vsimhas/CPAP_Micronel/assets/debug_video_frames/frame_005.jpg

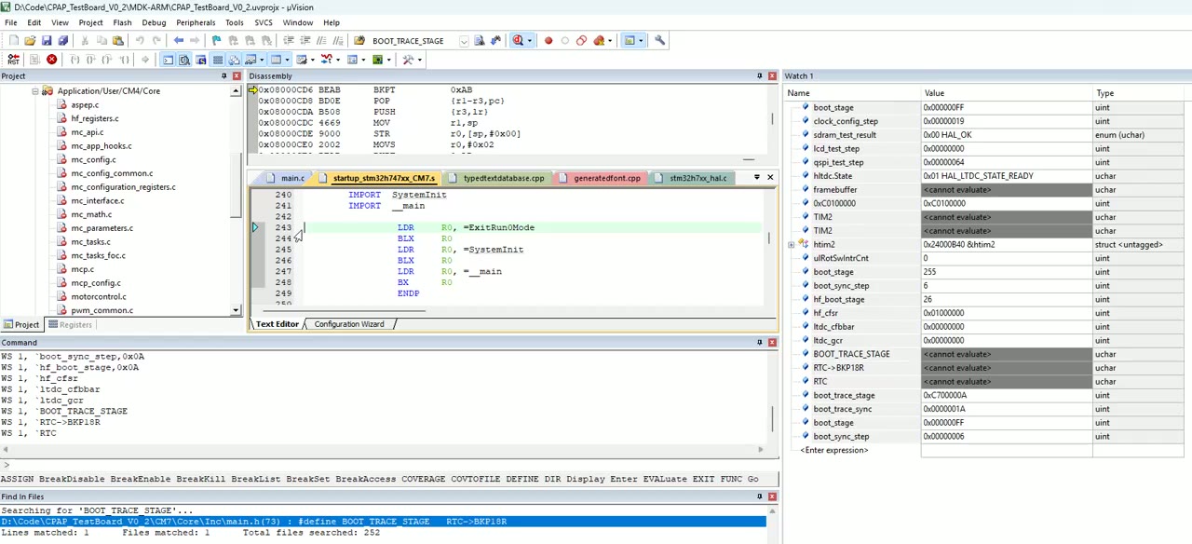
assets/debug_video_frames/frame_005.jpg
