vsimhas/CPAP_Micronel/assets/debug_video_frames/frame_004.jpg

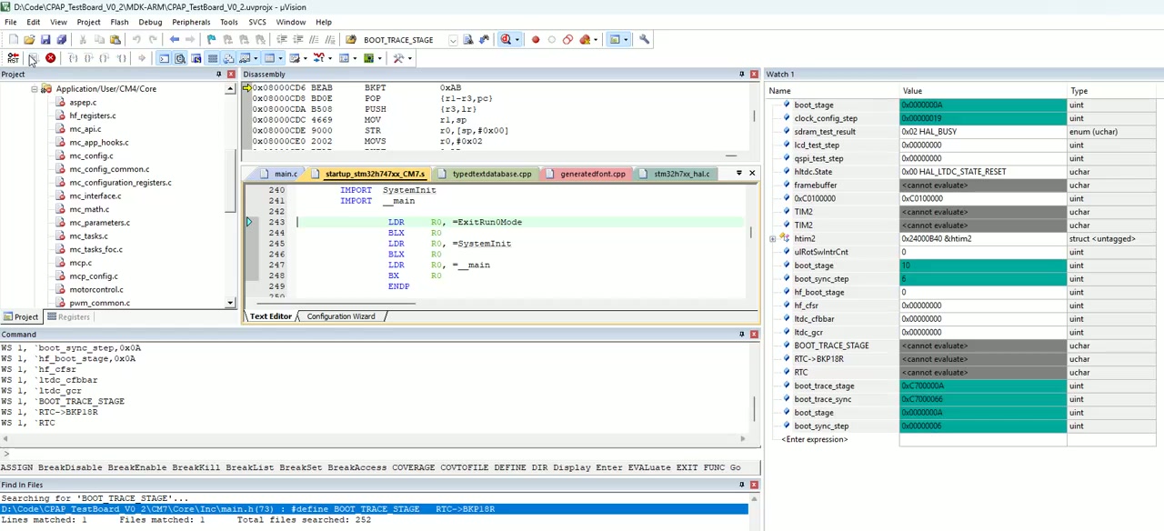
assets/debug_video_frames/frame_004.jpg
