vsimhas/CPAP_Micronel/README.md

# CPAP_InitialCode
Initial code creation and board testing code
