vsimhas/CPAP_Micronel/CM7/TouchGFX/assets/images/__generated/alternate_theme_images_backgrounds_480x272_puzzle.png

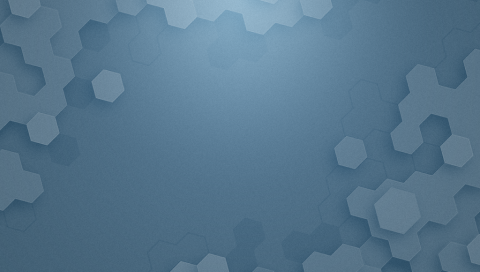
CM7/TouchGFX/assets/images/__generated/alternate_theme_images_backgrounds_480x272_puzzle.png
