vsimhas/CPAP_Micronel/mechanical/WM6850_Quiet_Enclosure/reference/datasheet_outline.png

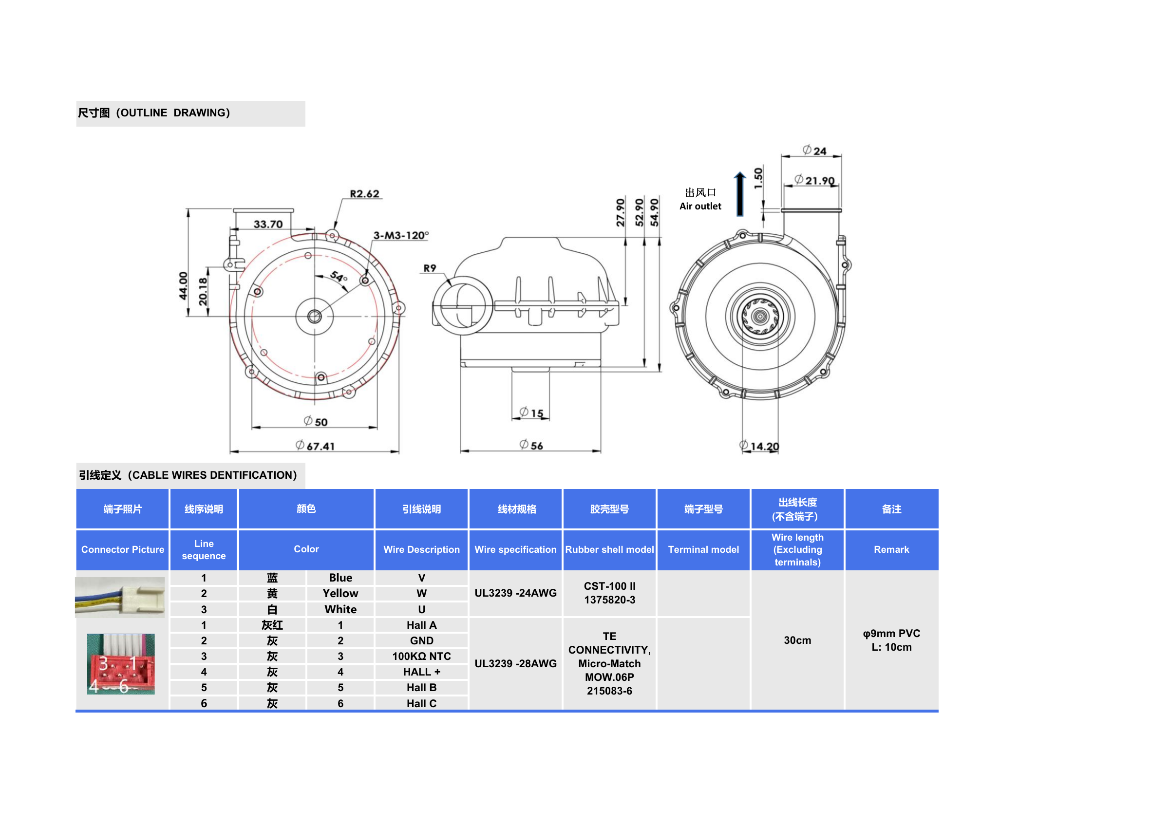
mechanical/WM6850_Quiet_Enclosure/reference/datasheet_outline.png
