vsimhas/CPAP_Micronel/mechanical/WM6850_Quiet_Enclosure/reference/review-6.png

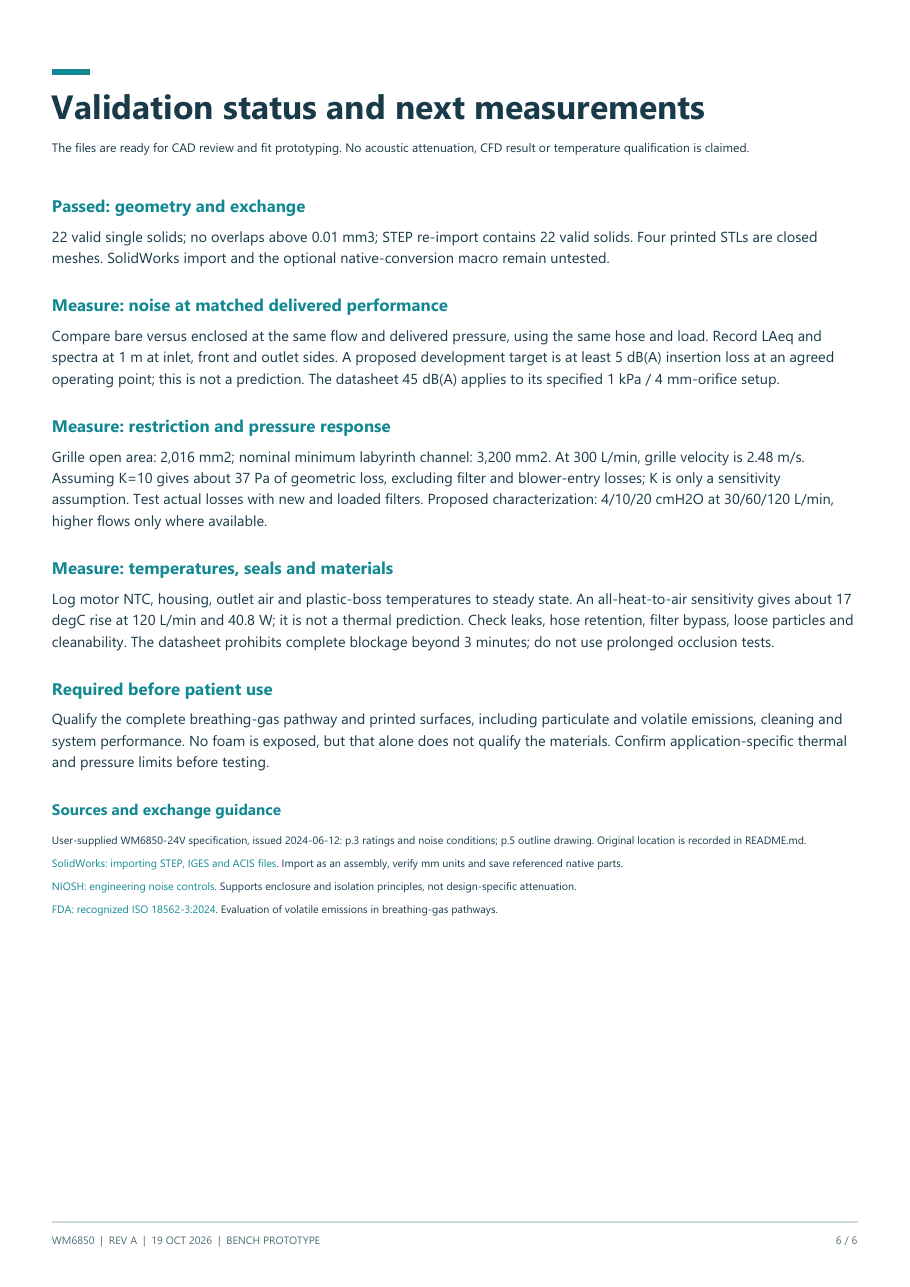
mechanical/WM6850_Quiet_Enclosure/reference/review-6.png
