vsimhas/CPAP_Micronel/mechanical/WM6850_Quiet_Enclosure/cad/step_parts/01_Base_with_intake_labyrinth.step

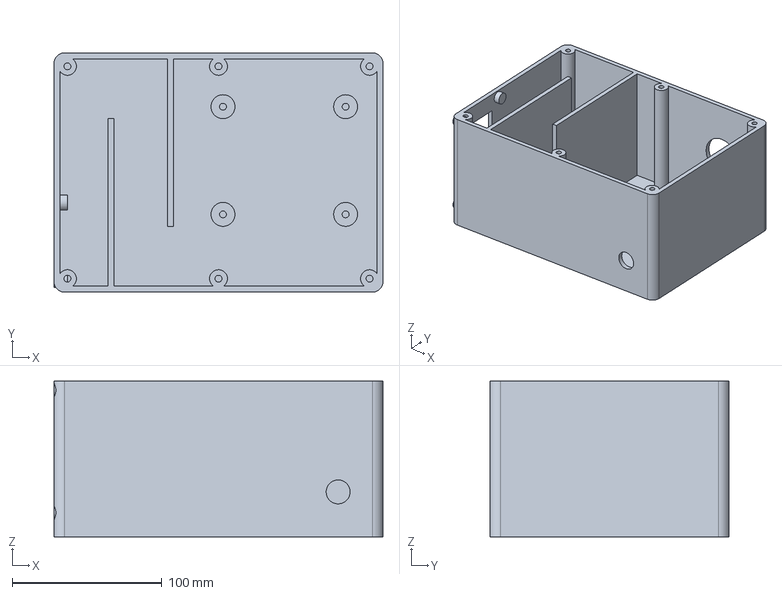
[picture p14: CAD file, 2026-10-20]
mechanical/WM6850_Quiet_Enclosure/cad/step_parts/01_Base_with_intake_labyrinth.step
220.0 x 160.0 x 104.0 mm
