vsimhas/CPAP_Micronel/mechanical/WM6850_Quiet_Enclosure/cad/WM6850_Quiet_Enclosure.step

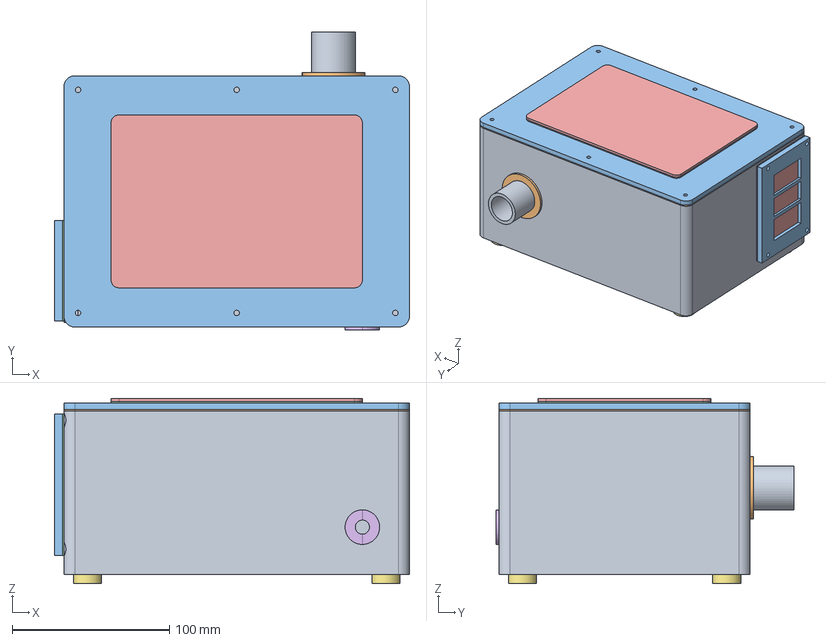
[picture p15: CAD file, 2026-10-20]
mechanical/WM6850_Quiet_Enclosure/cad/WM6850_Quiet_Enclosure.step
226.0 x 190.0 x 118.0 mm
01 Base with intake labyrinth
02 Rim and baffle gasket
03 Removable lid
04 External damping layer
05 External mass plate
06 Isolated blower carrier
07 Isolator 1
07 Isolator 2
07 Isolator 3
07 Isolator 4
08 WM6850 SUPPLIER ENVELOPE ONLY
09 Flexible outlet sleeve
10 Outlet wall grommet
11 Intake filter retainer
12 Filter frame gasket
13 Filter MEDIA ENVELOPE
14 Split cable gland half 1
14 Split cable gland half 2
15 External foot 1
15 External foot 2
15 External foot 3
15 External foot 4
