vsimhas/CPAP_Micronel/mechanical/WM6850_Quiet_Enclosure/cad/step_parts/13_Filter_MEDIA_ENVELOPE.step

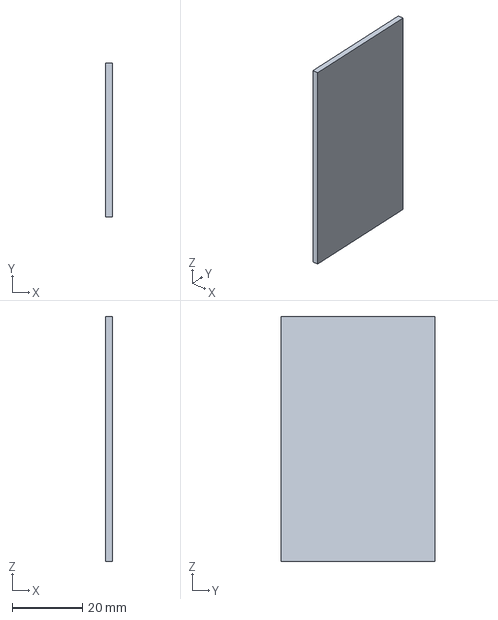
[picture p16: CAD file, 2026-10-20]
mechanical/WM6850_Quiet_Enclosure/cad/step_parts/13_Filter_MEDIA_ENVELOPE.step
2.00 x 44.0 x 70.0 mm
