vsimhas/CPAP_Micronel/mechanical/WM6850_Quiet_Enclosure/cad/step_parts/07_Isolator_3.step

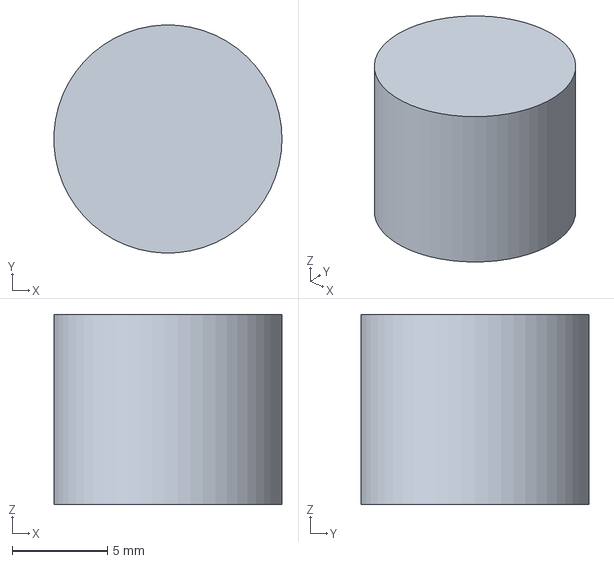
[picture p17: CAD file, 2026-10-20]
mechanical/WM6850_Quiet_Enclosure/cad/step_parts/07_Isolator_3.step
12.0 x 12.0 x 10.0 mm
