vsimhas/CPAP_Micronel/mechanical/WM6850_Quiet_Enclosure/cad/step_parts/05_External_mass_plate.step

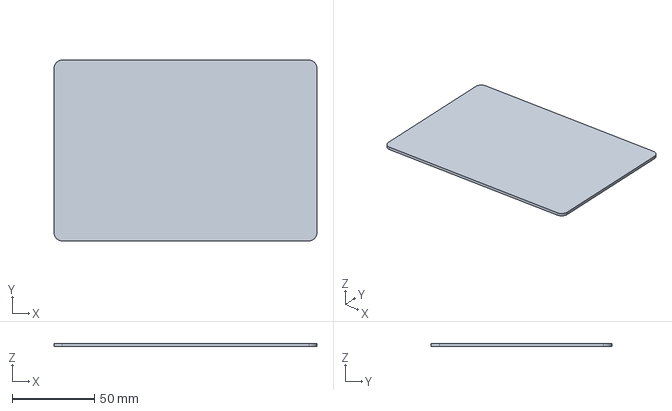
[picture p18: CAD file, 2026-10-20]
mechanical/WM6850_Quiet_Enclosure/cad/step_parts/05_External_mass_plate.step
160.0 x 110.0 x 2.00 mm
