vsimhas/CPAP_Micronel/mechanical/WM6850_Quiet_Enclosure/cad/step_parts/14_Split_cable_gland_half_1.step

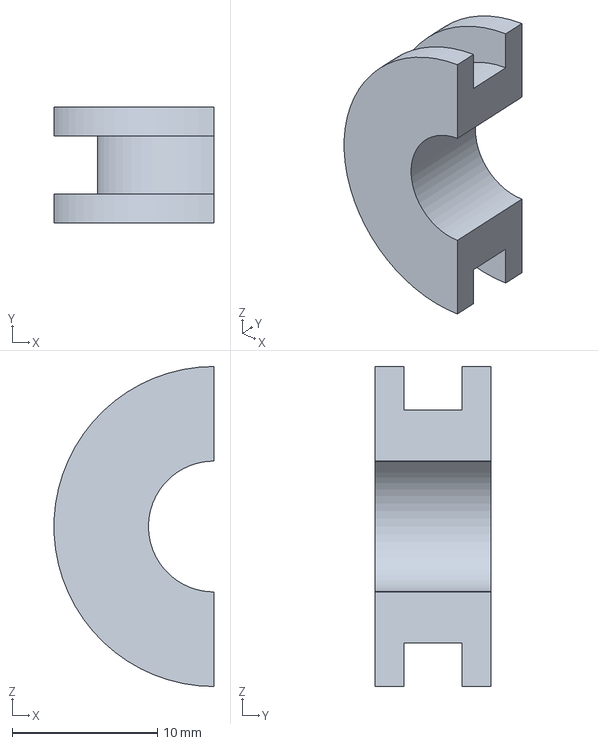
[picture p19: CAD file, 2026-10-20]
mechanical/WM6850_Quiet_Enclosure/cad/step_parts/14_Split_cable_gland_half_1.step
11.0 x 8.00 x 22.0 mm
