vsimhas/CPAP_Micronel/mechanical/WM6850_Quiet_Enclosure/cad/step_parts/15_External_foot_4.step

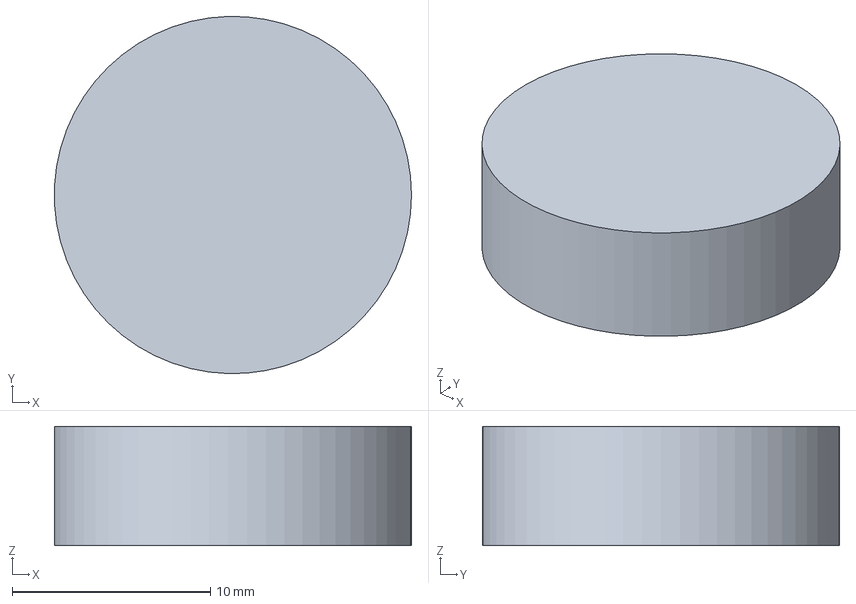
[picture p20: CAD file, 2026-10-20]
mechanical/WM6850_Quiet_Enclosure/cad/step_parts/15_External_foot_4.step
18.0 x 18.0 x 6.00 mm
