vsimhas/CPAP_Micronel/mechanical/WM6850_Quiet_Enclosure/cad/step_parts/08_WM6850_SUPPLIER_ENVELOPE_ONLY.step

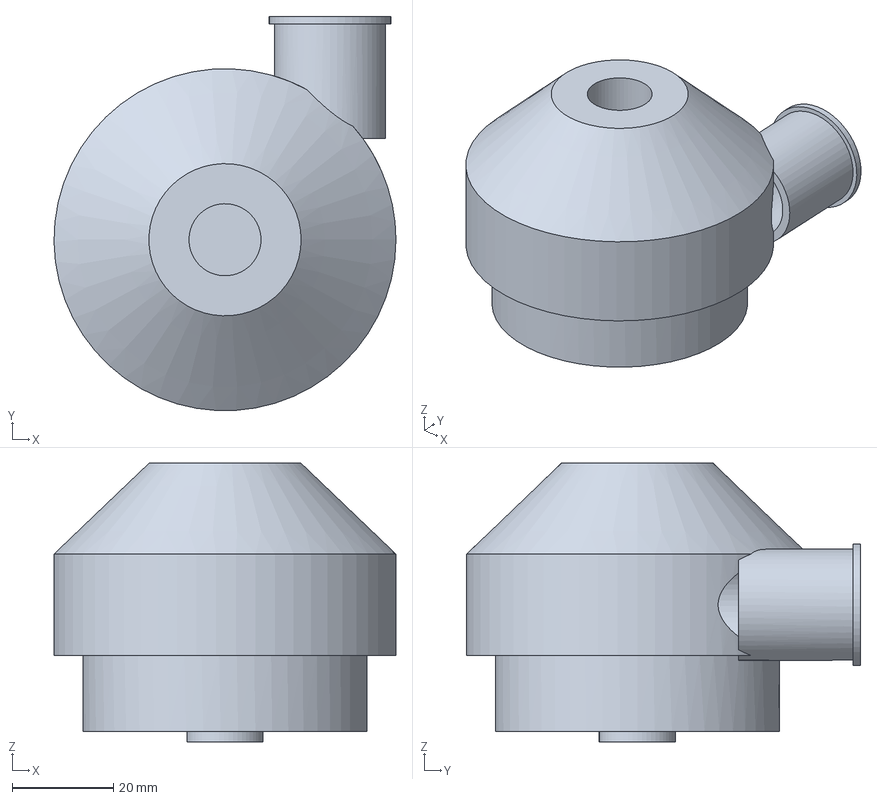
[picture p21: CAD file, 2026-10-20]
mechanical/WM6850_Quiet_Enclosure/cad/step_parts/08_WM6850_SUPPLIER_ENVELOPE_ONLY.step
67.4 x 77.7 x 54.9 mm
