vsimhas/CPAP_Micronel/mechanical/WM6850_Quiet_Enclosure/cad/step_parts/02_Rim_and_baffle_gasket.step

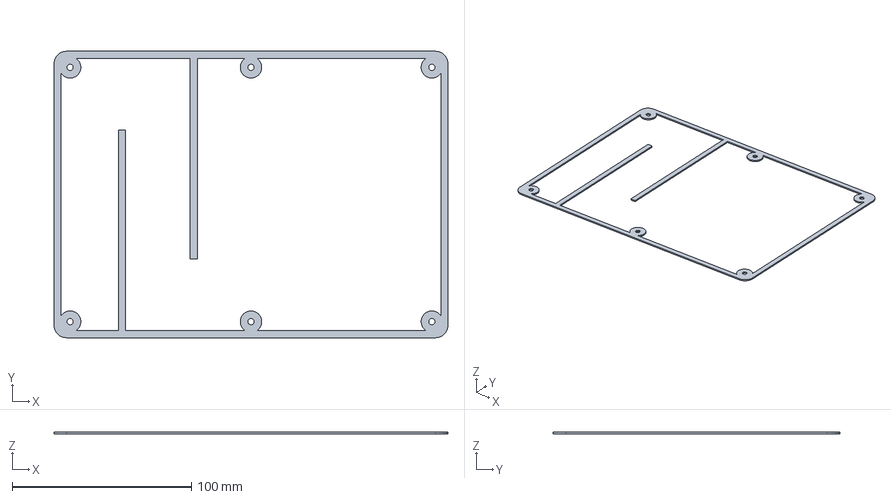
[picture p22: CAD file, 2026-10-20]
mechanical/WM6850_Quiet_Enclosure/cad/step_parts/02_Rim_and_baffle_gasket.step
220.0 x 160.0 x 1.00 mm
