vsimhas/CPAP_Micronel/mechanical/WM6850_Quiet_Enclosure/cad/step_parts/06_Isolated_blower_carrier.step

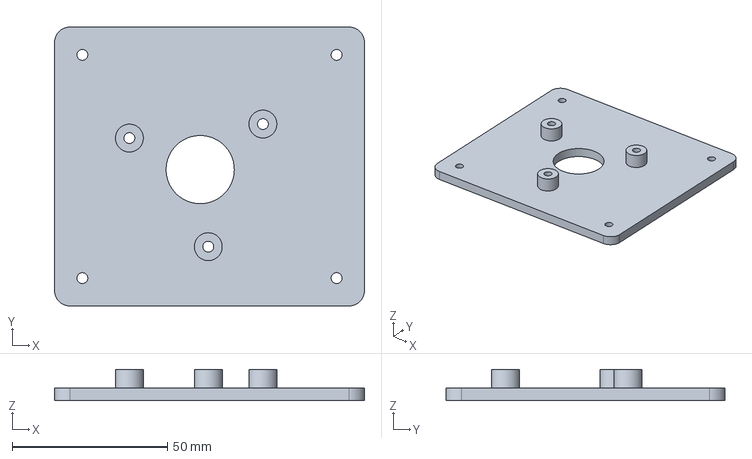
[picture p23: CAD file, 2026-10-20]
mechanical/WM6850_Quiet_Enclosure/cad/step_parts/06_Isolated_blower_carrier.step
100.0 x 90.0 x 10.0 mm
