vsimhas/CPAP_Micronel/mechanical/WM6850_Quiet_Enclosure/cad/step_parts/11_Intake_filter_retainer.step

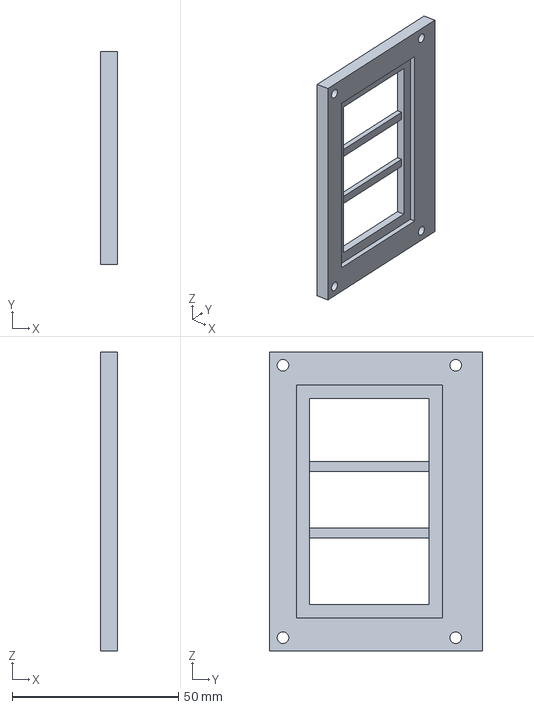
[picture p24: CAD file, 2026-10-20]
mechanical/WM6850_Quiet_Enclosure/cad/step_parts/11_Intake_filter_retainer.step
5.00 x 64.0 x 90.0 mm
