vsimhas/CPAP_Micronel/mechanical/WM6850_Quiet_Enclosure/cad/step_parts/04_External_damping_layer.step

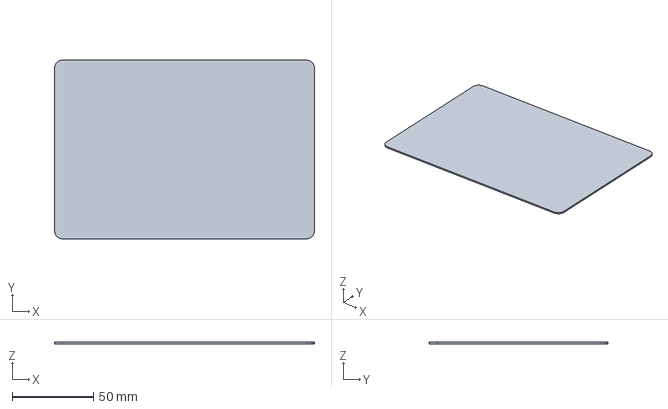
[picture p25: CAD file, 2026-10-20]
mechanical/WM6850_Quiet_Enclosure/cad/step_parts/04_External_damping_layer.step
160.0 x 110.0 x 1.00 mm
