vsimhas/CPAP_Micronel/mechanical/WM6850_Quiet_Enclosure/cad/step_parts/12_Filter_frame_gasket.step

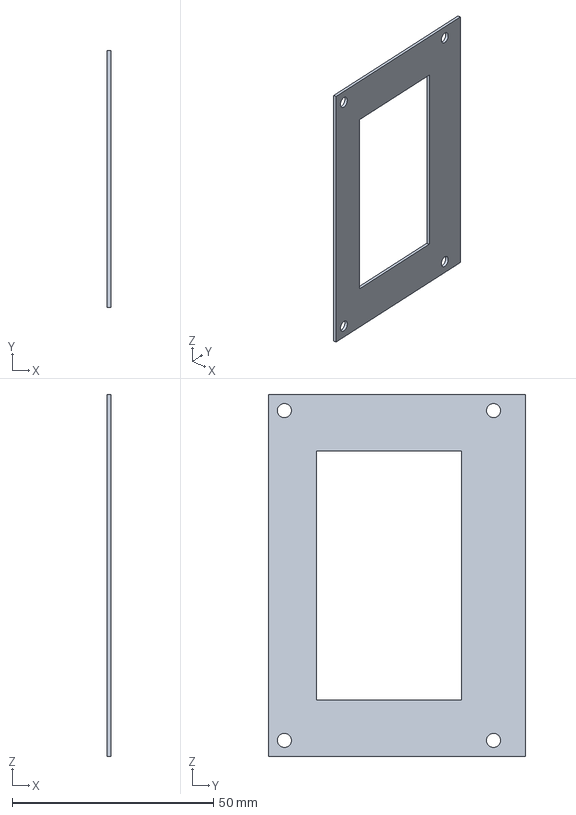
[picture p26: CAD file, 2026-10-20]
mechanical/WM6850_Quiet_Enclosure/cad/step_parts/12_Filter_frame_gasket.step
1.00 x 64.0 x 90.0 mm
