vsimhas/CPAP_Micronel/mechanical/WM6850_Quiet_Enclosure/cad/step_parts/10_Outlet_wall_grommet.step

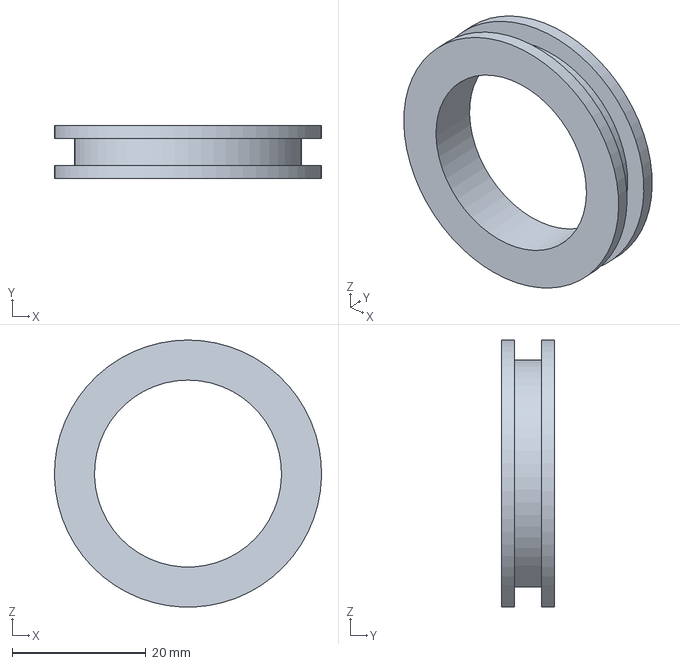
[picture p27: CAD file, 2026-10-20]
mechanical/WM6850_Quiet_Enclosure/cad/step_parts/10_Outlet_wall_grommet.step
40.0 x 8.00 x 40.0 mm
