vsimhas/CPAP_Micronel/mechanical/WM6850_Quiet_Enclosure/cad/step_parts/09_Flexible_outlet_sleeve.step

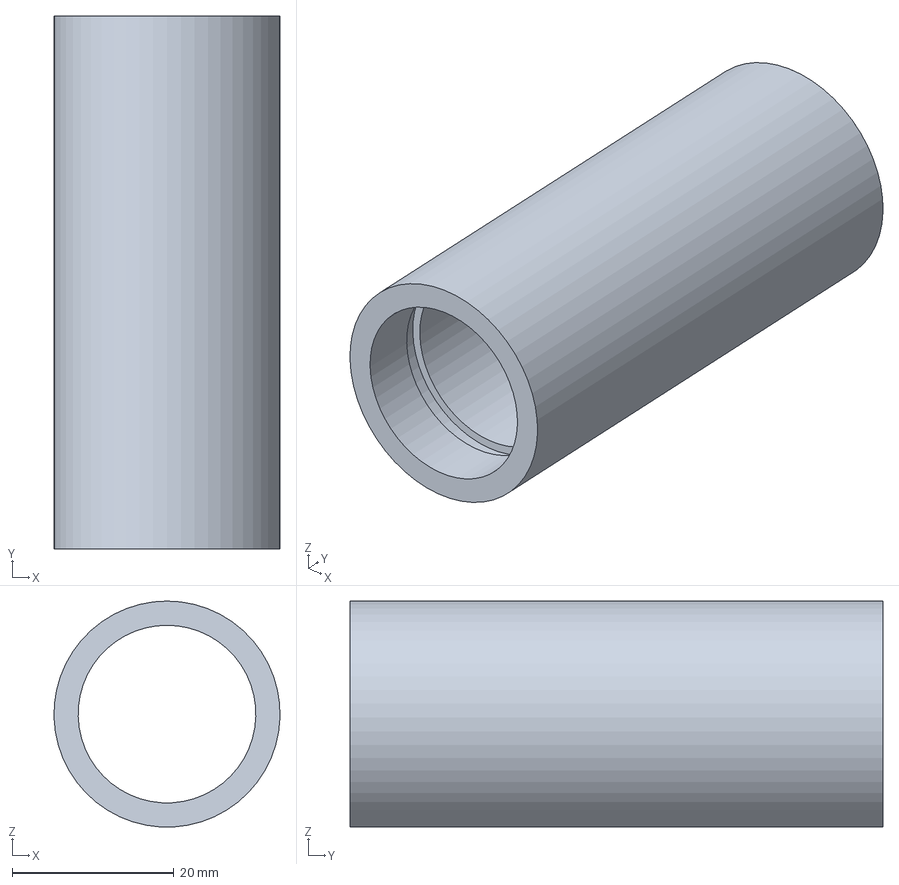
[picture p28: CAD file, 2026-10-20]
mechanical/WM6850_Quiet_Enclosure/cad/step_parts/09_Flexible_outlet_sleeve.step
28.0 x 66.0 x 28.0 mm
