vsimhas/CPAP_Micronel/mechanical/WM6850_Quiet_Enclosure/cad/step_parts/03_Removable_lid.step

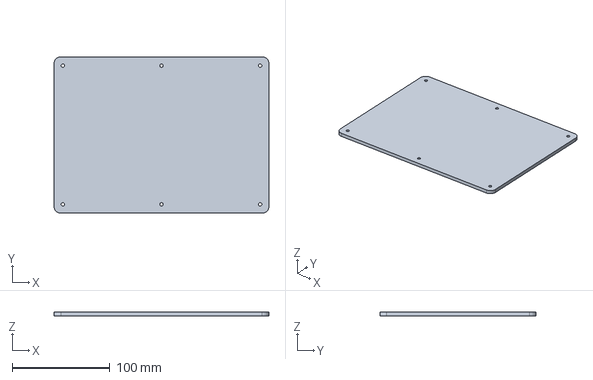
[picture p29: CAD file, 2026-10-20]
mechanical/WM6850_Quiet_Enclosure/cad/step_parts/03_Removable_lid.step
220.0 x 160.0 x 4.00 mm
