vsimhas/CPAP_Micronel/(list of files, cad)

Other CAD files:
mechanical/WM6850_Quiet_Enclosure/cad/step_parts/07_Isolator_2.step
mechanical/WM6850_Quiet_Enclosure/cad/step_parts/07_Isolator_4.step
mechanical/WM6850_Quiet_Enclosure/cad/step_parts/07_Isolator_1.step
mechanical/WM6850_Quiet_Enclosure/cad/step_parts/15_External_foot_2.step
mechanical/WM6850_Quiet_Enclosure/cad/step_parts/15_External_foot_1.step
mechanical/WM6850_Quiet_Enclosure/cad/step_parts/14_Split_cable_gland_half_2.step
mechanical/WM6850_Quiet_Enclosure/cad/step_parts/15_External_foot_3.step
mechanical/WM6850_Quiet_Enclosure/cad/WM6850_Quiet_Enclosure.FCStd
mechanical/WM6850_Quiet_Enclosure/cad/stl_print/01_Base_with_intake_labyrinth.stl
mechanical/WM6850_Quiet_Enclosure/cad/stl_print/03_Removable_lid.stl
mechanical/WM6850_Quiet_Enclosure/cad/stl_print/06_Isolated_blower_carrier.stl
mechanical/WM6850_Quiet_Enclosure/cad/stl_print/11_Intake_filter_retainer.stl
