vsimhas/CPAP_Micronel/mechanical/WM6850_Quiet_Enclosure/output/assembled.png

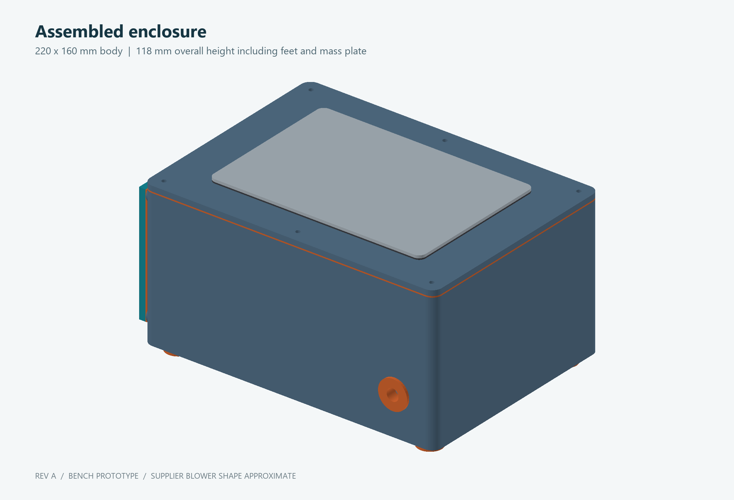
mechanical/WM6850_Quiet_Enclosure/output/assembled.png
