vsimhas/CPAP_Micronel/CM4/Core/Inc/drive_parameters.h

#define DRIVE_PARAMETERS_H
#define FOC_OVERMODULATION_ENABLE           1
#define MAX_APPLICATION_SPEED_RPM           40626
#define MIN_APPLICATION_SPEED_RPM           0
#define M1_SS_MEAS_ERRORS_BEFORE_FAULTS     3
#define VARIANCE_THRESHOLD                  0.25
#define F1                                  8192
#define F2                                  16384
#define F1_LOG                              LOG2((8192))
#define F2_LOG                              LOG2((16384))
#define GAIN1                               -10231
#define GAIN2                               9219
#define PLL_KP_GAIN                         1081
#define PLL_KI_GAIN                         38
#define PLL_KPDIV                           16384
#define PLL_KPDIV_LOG                       LOG2((PLL_KPDIV))
#define PLL_KIDIV                           65535
#define PLL_KIDIV_LOG                       LOG2((PLL_KIDIV))
#define STO_FIFO_DEPTH_DPP                  64
#define STO_FIFO_DEPTH_DPP_LOG              LOG2((64))
#define STO_FIFO_DEPTH_UNIT                 64
#define M1_BEMF_CONSISTENCY_TOL             64
#define M1_BEMF_CONSISTENCY_GAIN            64
#define PARK_ANGLE_COMPENSATION_FACTOR      0
#define REV_PARK_ANGLE_COMPENSATION_FACTOR  0
#define PWM_FREQUENCY                       40000
#define PWM_FREQ_SCALING                    1
#define LOW_SIDE_SIGNALS_ENABLING           ES_GPIO
#define REGULATION_EXECUTION_RATE           2
#define ISR_FREQUENCY_HZ                    (PWM_FREQUENCY/REGULATION_EXECUTION_RATE)
#define PID_TORQUE_KP_DEFAULT               3412
#define PID_TORQUE_KI_DEFAULT               2285
#define PID_TORQUE_KD_DEFAULT               100
#define PID_FLUX_KP_DEFAULT                 3412
#define PID_FLUX_KI_DEFAULT                 2285
#define PID_FLUX_KD_DEFAULT                 100
#define TF_KPDIV                            8192
#define TF_KIDIV                            16384
#define TF_KDDIV                            8192
#define TF_KPDIV_LOG                        LOG2((8192))
#define TF_KIDIV_LOG                        LOG2((16384))
#define TF_KDDIV_LOG                        LOG2((8192))
#define TFDIFFERENTIAL_TERM_ENABLING        DISABLE
#define PID_SPEED_KP_DEFAULT                1637/(SPEED_UNIT/10)
#define PID_SPEED_KI_DEFAULT                1024/(SPEED_UNIT/10)
#define PID_SPEED_KD_DEFAULT                0/(SPEED_UNIT/10)
#define SPEED_LOOP_FREQUENCY_HZ             (uint16_t)1000
#define SP_KPDIV                            128
#define SP_KIDIV                            16384
#define SP_KDDIV                            16
#define SP_KPDIV_LOG                        LOG2((128))
#define SP_KIDIV_LOG                        LOG2((16384))
#define SP_KDDIV_LOG                        LOG2((16))
#define PID_SPEED_INTEGRAL_INIT_DIV         0
#define SPD_DIFFERENTIAL_TERM_ENABLING      DISABLE
#define IQMAX_A                             1.316
#define DEFAULT_CONTROL_MODE                MCM_SPEED_MODE
#define DEFAULT_TARGET_SPEED_RPM            14625
#define DEFAULT_TARGET_SPEED_UNIT           (DEFAULT_TARGET_SPEED_RPM*SPEED_UNIT/U_RPM)
#define DEFAULT_TORQUE_COMPONENT_A          0
#define DEFAULT_FLUX_COMPONENT_A            0
#define OV_VOLTAGE_THRESHOLD_V              28.0
#define UD_VOLTAGE_THRESHOLD_V              7.0
#ifdef NOT_IMPLEMENTED
#define ON_OVER_VOLTAGE                     TURN_OFF_PWM
#endif
#define OV_TEMPERATURE_THRESHOLD_C          110
#define OV_TEMPERATURE_HYSTERESIS_C         10
#define HW_OV_CURRENT_PROT_BYPASS           DISABLE
#define OVP_INVERTINGINPUT_MODE             INT_MODE
#define OVP_INVERTINGINPUT_MODE2            INT_MODE
#define OVP_SELECTION                       COMP_Selection_COMP1
#define OVP_SELECTION2                      COMP_Selection_COMP1
#define PHASE1_DURATION                     1000
#define PHASE1_FINAL_SPEED_UNIT             (0*SPEED_UNIT/U_RPM)
#define PHASE1_FINAL_CURRENT_A              1.316
#define PHASE2_DURATION                     4322
#define PHASE2_FINAL_SPEED_UNIT             (16250*SPEED_UNIT/U_RPM)
#define PHASE2_FINAL_CURRENT_A              1.316
#define PHASE3_DURATION                     0
#define PHASE3_FINAL_SPEED_UNIT             (16250*SPEED_UNIT/U_RPM)
#define PHASE3_FINAL_CURRENT_A              1.316
#define PHASE4_DURATION                     0
#define PHASE4_FINAL_SPEED_UNIT             (16250*SPEED_UNIT/U_RPM)
#define PHASE4_FINAL_CURRENT_A              1.316
#define PHASE5_DURATION                     0
#define PHASE5_FINAL_SPEED_UNIT             (16250*SPEED_UNIT/U_RPM)
#define PHASE5_FINAL_CURRENT_A              1.316
#define ENABLE_SL_ALGO_FROM_PHASE           2
#define STARTING_ANGLE_DEG                  0
#define OBS_MINIMUM_SPEED_RPM               14625
#define NB_CONSECUTIVE_TESTS                2
#define SPEED_BAND_UPPER_LIMIT              17
#define SPEED_BAND_LOWER_LIMIT              15
#define TRANSITION_DURATION                 25
#define  M1_VBUS_SAMPLING_TIME              LL_ADC_SAMPLING_CYCLE(64)
#define  M1_TEMP_SAMPLING_TIME              LL_ADC_SAMPLING_CYCLE(64)
#define ADC_SAMPLING_CYCLES                 (8 + SAMPLING_CYCLE_CORRECTION)
