vsimhas/CPAP_Micronel/CM4/Core/Inc/main.h

#define M1_BUS_VOLTAGE_Pin GPIO_PIN_0
#define M1_BUS_VOLTAGE_GPIO_Port GPIOA
#define M1_CURR_AMPL_U_Pin GPIO_PIN_1
#define M1_CURR_AMPL_U_GPIO_Port GPIOA
#define M1_DP_Pin GPIO_PIN_6
#define M1_DP_GPIO_Port GPIOA
#define M1_CURR_AMPL_W_Pin GPIO_PIN_7
#define M1_CURR_AMPL_W_GPIO_Port GPIOA
#define M1_TEMPERATURE_Pin GPIO_PIN_4
#define M1_TEMPERATURE_GPIO_Port GPIOC
#define M1_CURR_AMPL_V_Pin GPIO_PIN_1
#define M1_CURR_AMPL_V_GPIO_Port GPIOB
#define UART_TX_Pin GPIO_PIN_10
#define UART_TX_GPIO_Port GPIOB
#define UART_RX_Pin GPIO_PIN_11
#define UART_RX_GPIO_Port GPIOB
#define STSPIN_STBY_Pin GPIO_PIN_13
#define STSPIN_STBY_GPIO_Port GPIOB
#define M1_PWM_EN_V_Pin GPIO_PIN_14
#define M1_PWM_EN_V_GPIO_Port GPIOB
#define M1_PWM_EN_W_Pin GPIO_PIN_15
#define M1_PWM_EN_W_GPIO_Port GPIOB
#define MOT_POW_EN_Pin GPIO_PIN_11
#define MOT_POW_EN_GPIO_Port GPIOD
#define M1_PWM_UH_Pin GPIO_PIN_6
#define M1_PWM_UH_GPIO_Port GPIOC
#define M1_PWM_VH_Pin GPIO_PIN_7
#define M1_PWM_VH_GPIO_Port GPIOC
#define M1_PWM_EN_U_Pin GPIO_PIN_13
#define M1_PWM_EN_U_GPIO_Port GPIOH
#define GREEN_LED_Pin GPIO_PIN_4
#define GREEN_LED_GPIO_Port GPIOD
#define M1_PWM_WH_Pin GPIO_PIN_7
#define M1_PWM_WH_GPIO_Port GPIOI
#define BRAKE_PWM_Pin GPIO_PIN_4
#define BRAKE_PWM_GPIO_Port GPIOB
