vsimhas/CPAP_Micronel/CM7/Core/Inc/main.h

#define BOOT_TRACE_STAGE   boot_trace_stage
#define BOOT_TRACE_SYNC    boot_trace_sync
#define SDIO_DET_Pin GPIO_PIN_3
#define SDIO_DET_GPIO_Port GPIOE
#define SPI4_CS1_Pin GPIO_PIN_4
#define SPI4_CS1_GPIO_Port GPIOE
#define NFC_INT_Pin GPIO_PIN_8
#define NFC_INT_GPIO_Port GPIOI
#define NFC_INT_EXTI_IRQn EXTI9_5_IRQn
#define OTG_FS_PWR_ON_Pin GPIO_PIN_13
#define OTG_FS_PWR_ON_GPIO_Port GPIOC
#define SPI1_CS_Pin GPIO_PIN_4
#define SPI1_CS_GPIO_Port GPIOA
#define BL_CTL_Pin GPIO_PIN_0
#define BL_CTL_GPIO_Port GPIOB
#define SPI2_CS_Pin GPIO_PIN_12
#define SPI2_CS_GPIO_Port GPIOB
#define SPI4_CS2_Pin GPIO_PIN_3
#define SPI4_CS2_GPIO_Port GPIOG
#define ESP32_TX_Pin GPIO_PIN_5
#define ESP32_TX_GPIO_Port GPIOD
#define ESP32_RX_Pin GPIO_PIN_6
#define ESP32_RX_GPIO_Port GPIOD
#define ROT_SW_Pin GPIO_PIN_5
#define ROT_SW_GPIO_Port GPIOB
#define ROT_SW_EXTI_IRQn EXTI9_5_IRQn
