vsimhas/CPAP_Micronel/CM7/Core/Inc/blower_ctrl.h

/**
  ******************************************************************************
  * @file    blower_ctrl.h
  * @brief   Outer pressure-control PID for the CPAP blower. Runs on CM7,
  *          posts speed targets to the CM4 motor controller via the existing
  *          blower IPC mailbox.
  *
  *  Topology
  *  --------
  *      Setpoint (cmH2O)
  *           |
  *           v   (slewed)
  *      [PID @ 200 Hz on CM7]  <--- pressure_meas (cmH2O, from measPS)
  *           |
  *           v   (rpm reference)
  *      [BlowerIpc_CM7_SetSpeedRpmSilent]  ->  CM4 FOC inner loop
  *
  *  Why gain scheduling
  *  -------------------
  *  CPAP blowers are non-linear: at low therapy pressures (~4 cmH2O) the
  *  RPM-to-pressure slope is steep (small RPM step -> large pressure swing,
  *  so the loop needs LOW gains), while at high pressures (~20 cmH2O) the
  *  blower has already done most of the air-moving work and small pressure
  *  changes need bigger RPM corrections (so the loop needs HIGHER gains).
  *
  *  This module exposes three (Kp, Ki, Kd) sets selected by the *current
  *  setpoint*. We schedule on the setpoint - not the measurement - because
  *  setpoint is monotonic and slew-limited, while a noisy measurement at
  *  the boundary would chatter between zones.
  *
 *  All gains and feature flags are debugger-visible volatile globals so
 *  you can tune live with the Keil watch window or via STM Studio.
 *
 *  WM6850 reference mode
 *  ---------------------
 *  Set g_blower_ctrl_wm6850_mode = 1 for pressure_pid.c-compatible behaviour
 *  (see blower_ctrl.c design note 8). PID runs at 100 Hz (every 2nd 5 ms
 *  SensorTask tick). Overrides FF/slew/zones/tube-comp on the PID path.
 *  Tune via g_blower_ctrl_wm6850_kp/ki/kd.
  ******************************************************************************
  */

#ifndef BLOWER_CTRL_H
#define BLOWER_CTRL_H

#ifdef __cplusplus
extern "C" {
#endif

#include <stdint.h>
#include <stdbool.h>

/* CPAP therapy range expected by the controller. The setpoint is clamped
 * to [BLOWER_CTRL_SETPOINT_MIN, BLOWER_CTRL_SETPOINT_MAX] regardless of
 * what the caller passes in. */
#define BLOWER_CTRL_SETPOINT_MIN_CMH2O   4.0f
#define BLOWER_CTRL_SETPOINT_MAX_CMH2O   25.0f

/* Upper bound on the fan-curve coefficient (physicsFfRpmForSetpointAndFlow).
 *
 * Lives in the header because the USB setter has to clamp to the SAME value.
 * It did not, and that cost two weeks: when this ceiling was raised from
 * 0.001 on 2026-09-08 the setter in telemetry_stream.c kept its own 0.001
 * literal, so every "blower set physics_ff_c_fan" above 0.001 was silently
 * clipped - while still acking. Bench sweeps of c_fan therefore measured a
 * constant, and three of them read as "c_fan has no effect" before the
 * extended D line showed the fan term pinned at 0.001 x Q^2.
 * Keep the two in step by keeping them one symbol. */
#define BLOWER_CTRL_C_FAN_MAX            0.005f

/* Zone boundaries used for gain scheduling. Anything below LOW_HI uses the
 * "low" set; anything between LOW_HI and MID_HI uses "mid"; anything above
 * MID_HI uses "high". A small hysteresis prevents zone flapping at the
 * boundaries. */
#define BLOWER_CTRL_ZONE_LOW_HI_CMH2O    8.0f
#define BLOWER_CTRL_ZONE_MID_HI_CMH2O    15.0f
#define BLOWER_CTRL_ZONE_HYST_CMH2O      0.5f

/* Identifies which gain set was used in the most recent step. Useful to
 * watch in the debugger; also drives the Diagnostics page if you want to
 * surface it later. */
typedef enum
{
    BLOWER_CTRL_ZONE_LOW = 0,
    BLOWER_CTRL_ZONE_MID,
    BLOWER_CTRL_ZONE_HIGH
} BlowerCtrlZone_t;

/* Public API ---------------------------------------------------------------- */

/* Reset internal state and load default gains. Call once before the loop
 * task starts using the controller. */
void BlowerCtrl_Init(void);

/* Master enable/disable. While disabled the controller does not post any
 * IPC commands - manual blower control (g_bench_blower_enable, debugger writes)
 * keeps working. While enabled the controller owns target_speed_rpm. */
void BlowerCtrl_SetEnable(bool en);
bool BlowerCtrl_IsEnabled(void);

/* Update the user setpoint in cmH2O. The controller slews internally
 * toward this target at g_blower_ctrl_slew_cmh2o_per_s so a step input
 * does not provoke huge transient overshoot or anti-windup glitches. */
void BlowerCtrl_SetSetpoint(float cmh2o);
/* Set user + slewed setpoint immediately (therapy start / EPR snap). */
void BlowerCtrl_SnapSetpoint(float cmh2o);
/* Set therapy target without forcing slewed SP (mask-resume soft climb). */
void BlowerCtrl_SetUserSetpointOnly(float cmh2o);
float BlowerCtrl_GetSetpoint(void);          /* user setpoint              */
float BlowerCtrl_GetSetpointSlewed(void);    /* internal slewed target     */
float BlowerCtrl_GetMeasured(void);          /* PID measurement (mask est.) */
float BlowerCtrl_GetSensorCmh2o(void);       /* device-side AMS5935 cmH2O  */
float BlowerCtrl_GetOutputRpm(void);         /* last commanded rpm         */
/* Last PID step requested the upper cap, or posted within 50 RPM of it.
 * Uses the active cap (including WM6850), not the lower-limit saturation flag.
 * False with the PID disabled; therapy observes the preceding PID tick. */
bool BlowerCtrl_IsUpperLimited(void);

/* Open-loop manual blower (USB / bench). Stops pressure PID and posts RPM
 * targets directly to CM4 with optional CM4-side ramp. */
void BlowerCtrl_ManualStart(int32_t rpm, uint16_t ramp_ms);
void BlowerCtrl_ManualSetSpeed(int32_t rpm, uint16_t ramp_ms);
void BlowerCtrl_ManualStop(void);
/* Clear manual mode without posting STOP (mask-on resume). */
void BlowerCtrl_ClearManualFlag(void);
bool BlowerCtrl_IsManualActive(void);

/* Run one PID iteration. Should be called periodically from the sensor
 * task at 5 ms (200 Hz). WM6850 mode decimates internally to 100 Hz.
 * dt_s is the elapsed seconds since the previous call. */
void BlowerCtrl_Step(float dt_s);

/* Enforce mutual exclusion between physics FF and legacy sqrt/flow/dip FF. */
void BlowerCtrl_EnforceFfMutualExclusion(void);

/* CPAP Plateau preset (AirSense-like flat pressure platform).
 * Prefer=1 → sticky A/B flag; Sync applies on CPAP / restores on Autoset.
 * Preset: sqrt FF only, no flow/physics/dip FF, soft P gains, heavier LPF. */
void BlowerCtrl_SetCpapPlateauPrefer(bool prefer);
bool BlowerCtrl_IsCpapPlateauPreferred(void);
bool BlowerCtrl_IsCpapPlateauActive(void);

/* CPAP Hybrid: Physics FF on inspiration, plateau-style hold on expiration.
 * Mutually exclusive with Plateau prefer. Disable via prefer=0 if not helpful. */
void BlowerCtrl_SetCpapHybridPrefer(bool prefer);
bool BlowerCtrl_IsCpapHybridPreferred(void);
bool BlowerCtrl_IsCpapHybridActive(void);

/* Apply/restore Plateau + Hybrid for current therapy mode (CPAP vs Autoset). */
void BlowerCtrl_SyncCpapProfilesForMode(uint8_t therapy_mode);

/* Deprecated alias — calls SyncCpapProfilesForMode. */
void BlowerCtrl_SyncCpapPlateauForMode(uint8_t therapy_mode);

/* After mask-off hold: snap setpoint and reseed FF/PID so pressure
 * recovers to therapy target instead of lingering near hold-RPM pressure.
 * Call AFTER BlowerCtrl_SetEnable(true) so rising-edge init cannot wipe the seed. */
void BlowerCtrl_ReseedForTherapyResume(float target_cmh2o);

/* Mask reconnect: set therapy target but start slew/RPM from the hold point
 * so sqrt-FF does not jump straight to full steady-state (pressure overshoot). */
void BlowerCtrl_BeginMaskResume(float target_cmh2o, float start_rpm);

/* After mask reconnect, ignore Vivo Q_patient in flow/dip FF for ms (MeanRatio
 * reseed briefly attributes fill flow to the patient). */
void BlowerCtrl_SuppressPatientFlowFf(uint32_t duration_ms);

/* Floor commanded RPM for duration_ms after mask-on (prevents Step posting 0). */
void BlowerCtrl_SetResumeRpmFloor(float rpm, uint32_t duration_ms);

/* Sqrt-FF estimate of open-circuit RPM for a pressure target (debug/resume). */
float BlowerCtrl_EstimateSteadyStateRpm(float target_cmh2o);

/* Therapy parks the blower itself during mask-off, with the PID disabled and
 * Step() no longer refreshing the output registers. Publish the parked RPM so
 * GetOutputRpm() reports what the motor is actually being asked for instead of
 * the last pre-park command (the safety supervisor and telemetry read it). */
void BlowerCtrl_NoteParkedRpm(float rpm);

#ifdef __cplusplus
}
#endif

#endif /* BLOWER_CTRL_H */
