vsimhas/CPAP_Micronel/CM7/Core/Inc/pressure_sensors.h

#ifndef __PRESSURE_SENSORS_H
#define __PRESSURE_SENSORS_H

#include "stm32h7xx_hal.h"
#include <stdint.h>

typedef struct
{
    uint8_t status;
    uint32_t pressure_raw;
    uint32_t temperature_raw;
    float pressure;
    float temperature_c;
} AMS5935_Data_t;

typedef struct
{
    SPI_HandleTypeDef *hspi;

    GPIO_TypeDef *cs_port;
    uint16_t cs_pin;

    GPIO_TypeDef *eoc_port;
    uint16_t eoc_pin;
    uint8_t use_eoc;

    float p_min;
    float p_max;

    /* Last conversion that was not busy / memory-error / overflow.
     * ReadRaw substitutes this when the sensor reports a bad sample so
     * Flow_Update / PID never see a one-tick garbage ΔP. */
    uint8_t last_valid;
    AMS5935_Data_t last_good;

    /* 1 = the sample just returned by ReadRaw is a repeat of last_good,
     * not a finished conversion. Callers must not treat it as new data:
     * a frozen ΔP looks perfectly "quiet" to the auto-zero detector and
     * steps when fresh data resumes. */
    uint8_t held_last;
    uint32_t held_count;

    /* Opt-in, set by the caller BEFORE AMS5935_Init (Init leaves it alone).
     * 1 = a genuine over-range reading (analog-overflow status, or a payload
     * outside the 10-90% digital span) is returned as FULL SCALE - p_max or
     * p_min - instead of repeating the last good sample.
     *
     * Why: holding the last good sample is right for a torn or busy read,
     * which is a glitch, but wrong for over-range, which is information. On
     * the ±5 mbar flow sensor, over-range means total flow is ABOVE ~93 slm.
     * Holding instead froze the published flow at whatever it had reached on
     * the way up - measured 26.2, 40.7 and 52.6 slm on three runs - so a
     * disconnect-sized flow read as ordinary breathing, low enough to sit
     * under the mask-off enter threshold. Full scale is a true lower bound.
     *
     * Busy and memory-error reads still hold, saturation or not. */
    uint8_t saturate_on_overflow;

    /* 1 = the sample just returned by ReadRaw is a clipped full-scale value.
     * It IS fresh data (held_last is 0) - the quantity really is at least
     * this large - but consumers that need the true magnitude should know. */
    uint8_t saturated_last;
    uint32_t saturated_count;
} AMS5935_HandleTypeDef;

HAL_StatusTypeDef AMS5935_Init(AMS5935_HandleTypeDef *dev);
HAL_StatusTypeDef AMS5935_StartSingleMeasurement(AMS5935_HandleTypeDef *dev);
HAL_StatusTypeDef AMS5935_StartOversamplingMeasurement(AMS5935_HandleTypeDef *dev);
HAL_StatusTypeDef AMS5935_ReadRaw(AMS5935_HandleTypeDef *dev, AMS5935_Data_t *data);
HAL_StatusTypeDef AMS5935_ReadMeasurement(AMS5935_HandleTypeDef *dev,
                                          AMS5935_Data_t *data,
                                          uint8_t oversampling);

float AMS5935_ConvertPressure(uint32_t raw_p, float p_min, float p_max);
float AMS5935_ConvertTemperature(uint32_t raw_t);

/* 1 = last ReadRaw returned a repeated (held) sample, not fresh data. */
uint8_t AMS5935_WasSampleHeld(const AMS5935_HandleTypeDef *dev);

/* 1 = last ReadRaw returned a clipped full-scale sample (see
 * saturate_on_overflow). Fresh, but a lower bound rather than a value. */
uint8_t AMS5935_WasSampleSaturated(const AMS5935_HandleTypeDef *dev);

uint8_t AMS5935_StatusBusy(uint8_t status);
uint8_t AMS5935_StatusMemoryError(uint8_t status);
uint8_t AMS5935_StatusOverflow(uint8_t status);

extern volatile HAL_StatusTypeDef g_pressure_spi_last_status;
extern volatile uint16_t g_pressure_analog_adc_raw;
extern float g_pressure_analog_mbar;

uint16_t pressure_sensor_read_analog_adc_raw(void);

#endif
