vsimhas/CPAP_Micronel/MCSDK_v6.4.2-Full/MotorControl/MCSDK/MCLib/H7xx/Src/r3_2_h7xx_pwm_curr_fdbk.c

/**
  ******************************************************************************
  * @file    r3_2_h7xx_pwm_curr_fdbk.c
  * @author  Motor Control SDK Team, ST Microelectronics
  * @brief   This file provides firmware functions that implement current sensor
  *          class to be stantiated when the three shunts current sensing
  *          topology is used.
  * 
  *          It is specifically designed for STM32H7XX microcontrollers and
  *          implements the successive sampling of motor current using two ADCs.
  *           + MCU peripheral and handle initialization function
  *           + three shunt current sensing
  *           + space vector modulation function
  *           + ADC sampling function
  *
  ******************************************************************************
  * @attention
  *
  * <h2><center>&copy; Copyright (c) 2026 STMicroelectronics.
  * All rights reserved.</center></h2>
  *
  * This software component is licensed by ST under Ultimate Liberty license
  * SLA0044, the "License"; You may not use this file except in compliance with
  * the License. You may obtain a copy of the License at:
  *                             www.st.com/SLA0044
  *
  ******************************************************************************
  *
  * @ingroup R3_2_H7XX_pwm_curr_fdbk
  */

/* Includes ------------------------------------------------------------------*/
#include "r3_2_h7xx_pwm_curr_fdbk.h"
#include "mc_type.h"

/** @addtogroup MCSDK
  * @{
  */


/** @addtogroup ConvFOC
  * @{
  */

/** @addtogroup MCLLAPI
  * @{
  */
/** @addtogroup pwm_curr_fdbk
  * @{
  */

/** @addtogroup R3_2_pwm_curr_fdbk
  * @{
  */


/* Private defines -----------------------------------------------------------*/
#define TIMxCCER_MASK_CH123        ((uint16_t)  (LL_TIM_CHANNEL_CH1|LL_TIM_CHANNEL_CH1N|\
                                                 LL_TIM_CHANNEL_CH2|LL_TIM_CHANNEL_CH2N|\
                                                 LL_TIM_CHANNEL_CH3|LL_TIM_CHANNEL_CH3N))
#define NB_CONVERSIONS 16u
#define CCMR2_CH4_DISABLE 0x8FFFu   //

/* Private typedef -----------------------------------------------------------*/

/* Private function prototypes -----------------------------------------------*/
static void R3_2_TIMxInit( TIM_TypeDef * TIMx, PWMC_Handle_t * pHdl );
static void R3_2_ADCxInit( ADC_TypeDef * ADCx );
__STATIC_INLINE uint16_t R3_2_WriteTIMRegisters( PWMC_Handle_t * pHdl, uint16_t hCCR4Reg  );
static void R3_2_HFCurrentsPolarizationAB( PWMC_Handle_t * pHdl,ab_t * Iab );
static void R3_2_HFCurrentsPolarizationC( PWMC_Handle_t * pHdl, ab_t * Iab );
static void R3_2_SetAOReferenceVoltage( uint32_t DAC_Channel, uint16_t hDACVref );
uint16_t R3_2_SetADCSampPointPolarization( PWMC_Handle_t * pHdl) ;
static void R3_2_RLGetPhaseCurrents( PWMC_Handle_t * pHdl, ab_t * pStator_Currents );
static void R3_2_RLTurnOnLowSides( PWMC_Handle_t * pHdl, uint32_t ticks );
static void R3_2_RLSwitchOnPWM( PWMC_Handle_t * pHdl );

/*
  * @brief  Initializes TIMx, ADC, GPIO, DMA1 and NVIC for current reading
  *         in three shunt topology using STM32H7XX and two ADCs.
  * 
  * @param  pHandle: Handler of the current instance of the PWM component.
  */
__weak void R3_2_Init( PWMC_R3_2_Handle_t * pHandle )
{
  R3_2_OPAMPParams_t * OPAMPParams = pHandle->pParams_str->OPAMPParams;
  COMP_TypeDef * COMP_OCPAx = pHandle->pParams_str->CompOCPASelection;
  COMP_TypeDef * COMP_OCPBx = pHandle->pParams_str->CompOCPBSelection;
  COMP_TypeDef * COMP_OCPCx = pHandle->pParams_str->CompOCPCSelection;
  COMP_TypeDef * COMP_OVPx = pHandle->pParams_str->CompOVPSelection;
  TIM_TypeDef * TIMx = pHandle->pParams_str->TIMx;
  ADC_TypeDef * ADCx_1 = pHandle->pParams_str->ADCDataReg1[0];
  ADC_TypeDef * ADCx_2 = pHandle->pParams_str->ADCDataReg2[0];

  /*Check that _Super is the first member of the structure PWMC_R3_2_Handle_t */
  if ( ( uint32_t )pHandle == ( uint32_t )&pHandle->_Super )
  {
    /* disable IT and flags in case of LL driver usage
     * workaround for unwanted interrupt enabling done by LL driver */
    LL_ADC_DisableIT_EOC( ADCx_1 );
    LL_ADC_ClearFlag_EOC( ADCx_1 );
    LL_ADC_DisableIT_JEOC( ADCx_1 );
    LL_ADC_ClearFlag_JEOC( ADCx_1 );
    LL_ADC_DisableIT_EOC( ADCx_2 );
    LL_ADC_ClearFlag_EOC( ADCx_2 );
    LL_ADC_DisableIT_JEOC( ADCx_2 );
    LL_ADC_ClearFlag_JEOC( ADCx_2 );

    if ( TIMx == TIM1 )
    {
      /* TIM1 Counter Clock stopped when the core is halted */
      LL_DBGMCU_APB2_GRP1_FreezePeriph( LL_DBGMCU_APB2_GRP1_TIM1_STOP );
    }
#if defined(TIM8)
    else
    {
      /* TIM8 Counter Clock stopped when the core is halted */
      LL_DBGMCU_APB2_GRP1_FreezePeriph( LL_DBGMCU_APB2_GRP1_TIM8_STOP );
    }
#endif
    
    if ( OPAMPParams != NULL )
    {
      LL_OPAMP_Enable(OPAMPParams->OPAMPSelect_1[0]);
      LL_OPAMP_Enable(OPAMPParams->OPAMPSelect_2[0]);
    }

    /* Over current protection phase A */
    if ( COMP_OCPAx != NULL )
    {
      /* Inverting input*/
      if ( pHandle->pParams_str->CompOCPAInvInput_MODE != EXT_MODE )
      {
        if ( LL_COMP_GetInputMinus( COMP_OCPAx ) == LL_COMP_INPUT_MINUS_DAC1_CH1 )
        {
          R3_2_SetAOReferenceVoltage( LL_DAC_CHANNEL_1, ( uint16_t )( pHandle->pParams_str->DAC_OCP_Threshold ) );
        }
#if defined(DAC_CHANNEL2_SUPPORT)
        else if ( LL_COMP_GetInputMinus( COMP_OCPAx ) == LL_COMP_INPUT_MINUS_DAC1_CH2 )
        {
          R3_2_SetAOReferenceVoltage( LL_DAC_CHANNEL_2, ( uint16_t )( pHandle->pParams_str->DAC_OCP_Threshold ) );
        }
#endif
        else
        {
        }
      }
      /* Output */
      LL_COMP_Enable ( COMP_OCPAx );
      LL_COMP_Lock( COMP_OCPAx );
    }

    /* Over current protection phase B */
    if ( COMP_OCPBx != NULL )
    {
      LL_COMP_Enable ( COMP_OCPBx );
      LL_COMP_Lock( COMP_OCPBx );
    }

    /* Over current protection phase C */
    if ( COMP_OCPCx != NULL )
    {
      LL_COMP_Enable ( COMP_OCPCx );
      LL_COMP_Lock( COMP_OCPCx );
    }

    /* Over voltage protection */
    if ( COMP_OVPx != NULL )
    {
      /* Inverting input*/
      if ( pHandle->pParams_str->CompOVPInvInput_MODE != EXT_MODE )
      {
        if ( LL_COMP_GetInputMinus( COMP_OVPx ) == LL_COMP_INPUT_MINUS_DAC1_CH1 )
        {
          R3_2_SetAOReferenceVoltage( LL_DAC_CHANNEL_1, ( uint16_t )( pHandle->pParams_str->DAC_OVP_Threshold ) );
        }
#if defined(DAC_CHANNEL2_SUPPORT)
        else if ( LL_COMP_GetInputMinus( COMP_OVPx ) == LL_COMP_INPUT_MINUS_DAC1_CH2 )
        {
          R3_2_SetAOReferenceVoltage( LL_DAC_CHANNEL_2, ( uint16_t )( pHandle->pParams_str->DAC_OVP_Threshold ) );
        }
#endif
        else
        {
        }
      }
      /* Output */
      LL_COMP_Enable ( COMP_OVPx );
      LL_COMP_Lock( COMP_OVPx );
    }
    
    if (LL_ADC_IsEnabled (ADCx_1) == 0)
    {
      R3_2_ADCxInit (ADCx_1);
    }
    else 
    {
      /* Nothing to do ADCx_1 already configured */
    }
    if (LL_ADC_IsEnabled (ADCx_2) == 0)
    {
      R3_2_ADCxInit (ADCx_2);
    }    
    else 
    {
      /* Nothing to do ADCx_2 already configured */
    }

    R3_2_TIMxInit( TIMx, &pHandle->_Super );
    pHandle->ADCTriggerEdge = (uint16_t) LL_ADC_INJ_TRIG_EXT_RISING;
  }
}

/*
  * @brief Initializes @p ADCx peripheral for current sensing.
  * 
  */
static void R3_2_ADCxInit( ADC_TypeDef * ADCx )
{
  /* - Exit from deep-power-down mode */     
  LL_ADC_DisableDeepPowerDown(ADCx);
   
  if ( LL_ADC_IsInternalRegulatorEnabled(ADCx) == 0u)
  {
    /* Enable ADC internal voltage regulator */
    LL_ADC_EnableInternalRegulator(ADCx);
  
    /* Wait for Regulator Startup time, once for both */
    /* Note: Variable divided by 2 to compensate partially              */
    /*       CPU processing cycles, scaling in us split to not          */
    /*       exceed 32 bits register capacity and handle low frequency. */
    volatile uint32_t wait_loop_index = ((LL_ADC_DELAY_INTERNAL_REGUL_STAB_US / 10UL) * (SystemCoreClock / (100000UL * 2UL)));      
    while(wait_loop_index != 0UL)
    {
      wait_loop_index--;
    }
  }
  
  LL_ADC_StartCalibration( ADCx, LL_ADC_CALIB_OFFSET_LINEARITY, LL_ADC_SINGLE_ENDED );
  while ( LL_ADC_IsCalibrationOnGoing( ADCx ) == 1u ) 
  {
    /* Nothing to do */
  }
  /* ADC Enable (must be done after calibration) */
  /* ADC5-140924: Enabling the ADC by setting ADEN bit soon after polling ADCAL=0 
  * following a calibration phase, could have no effect on ADC 
  * within certain AHB/ADC clock ratio.
  */
  while ( LL_ADC_IsActiveFlag_ADRDY( ADCx ) == 0u )  
  { 
    LL_ADC_Enable( ADCx );
  }
  
  /* Start and immediately stop ADC conversion to completely flush the JSQR queue of context */
  LL_ADC_INJ_StartConversion( ADCx );
  LL_ADC_INJ_StopConversion( ADCx );

  while( LL_ADC_INJ_IsStopConversionOngoing( ADCx ) )
  {
    /* Nothing to do */
  }
  
  /* Set trigger mode to hardware to avoid instant conversion */
  LL_ADC_INJ_SetTriggerEdge( ADCx, LL_ADC_INJ_TRIG_EXT_RISING );

  /* Start injected conversion */
  LL_ADC_INJ_StartConversion( ADCx );

  /* TODO: check if not already done by MX */
  LL_ADC_INJ_SetQueueMode( ADCx, LL_ADC_INJ_QUEUE_2CONTEXTS_END_EMPTY );
 }

/*
  * @brief Initializes @p TIMx peripheral with @p pHdl handler for PWM generation.
  * 
  */
static void R3_2_TIMxInit( TIM_TypeDef * TIMx, PWMC_Handle_t * pHdl )
{
#if defined (__ICCARM__)
  #pragma cstat_disable = "MISRAC2012-Rule-11.3"
#endif /* __ICCARM__ */
  PWMC_R3_2_Handle_t * pHandle = ( PWMC_R3_2_Handle_t * )pHdl;
#if defined (__ICCARM__)
  #pragma cstat_restore = "MISRAC2012-Rule-11.3"
#endif /* __ICCARM__ */
  uint32_t Brk2Timeout = 1000;

  /* disable main TIM counter to ensure
   * a synchronous start by TIM2 trigger */
  LL_TIM_DisableCounter( TIMx );
  
  LL_TIM_SetTriggerOutput(TIMx, LL_TIM_TRGO_UPDATE);

  /* Enables the TIMx Preload on CC1 Register */
  LL_TIM_OC_EnablePreload( TIMx, LL_TIM_CHANNEL_CH1 );
  /* Enables the TIMx Preload on CC2 Register */
  LL_TIM_OC_EnablePreload( TIMx, LL_TIM_CHANNEL_CH2 );
  /* Enables the TIMx Preload on CC3 Register */
  LL_TIM_OC_EnablePreload( TIMx, LL_TIM_CHANNEL_CH3 );
  /* Enables the TIMx Preload on CC4 Register */
  LL_TIM_OC_EnablePreload( TIMx, LL_TIM_CHANNEL_CH4 );
  /* Prepare timer for synchronization */
  LL_TIM_GenerateEvent_UPDATE( TIMx );
  if ( pHandle->pParams_str->FreqRatio == 2u )
  {
    if ( pHandle->pParams_str->IsHigherFreqTim == HIGHER_FREQ )
    {
      if ( pHandle->pParams_str->RepetitionCounter == 3u )
      {
        /* Set TIMx repetition counter to 1 */
        LL_TIM_SetRepetitionCounter( TIMx, 1 );
        LL_TIM_GenerateEvent_UPDATE( TIMx );
        /* Repetition counter will be set to 3 at next Update */
        LL_TIM_SetRepetitionCounter( TIMx, 3 );
      }
    }
    LL_TIM_SetCounter( TIMx, ( uint32_t )( pHandle->Half_PWMPeriod ) - 1u );
  }
  else /* FreqRatio equal to 1 or 3 */
  {
    if ( pHandle->_Super.Motor == M1 )
    {
      if ( pHandle->pParams_str->RepetitionCounter == 3u )
      {
        /* Set TIMx repetition counter to 1 */
        LL_TIM_SetRepetitionCounter( TIMx, 1 );
        LL_TIM_GenerateEvent_UPDATE( TIMx );
        /* Repetition counter will be set to 3 at next Update */
        LL_TIM_SetRepetitionCounter( TIMx, 3 );
      }
      LL_TIM_SetCounter( TIMx, ( uint32_t )( pHandle->Half_PWMPeriod ) - 1u );

    }
    else
    {
    }
  }
  /* set TRGO back to CH4 to trig ADC on CH4 match */
  LL_TIM_SetTriggerOutput(TIMx, LL_TIM_TRGO_OC4REF);
  LL_TIM_ClearFlag_BRK( TIMx );
  while ((LL_TIM_IsActiveFlag_BRK2 (TIMx) == 1u) && (Brk2Timeout != 0u) )
  {
    LL_TIM_ClearFlag_BRK2( TIMx );
    Brk2Timeout--;
  }   
  
  LL_TIM_EnableIT_BRK( TIMx );

  /* Enable PWM channel */
  LL_TIM_CC_EnableChannel( TIMx, TIMxCCER_MASK_CH123 );

  LL_TIM_ClearFlag_UPDATE(TIMx);
  /* Enable Update IRQ */
  LL_TIM_EnableIT_UPDATE(TIMx);
}

/*
  * @brief  Stores into the @p pHdl the voltage present on Ia and Ib current 
  *         feedback analog channels when no current is flowing into the motor.
  * 
  */
__weak void R3_2_CurrentReadingPolarization( PWMC_Handle_t * pHdl )
{
#if defined (__ICCARM__)
  #pragma cstat_disable = "MISRAC2012-Rule-11.3"
#endif /* __ICCARM__ */
  PWMC_R3_2_Handle_t * pHandle = ( PWMC_R3_2_Handle_t * )pHdl;
#if defined (__ICCARM__)
  #pragma cstat_restore = "MISRAC2012-Rule-11.3"
#endif /* __ICCARM__ */
  TIM_TypeDef * TIMx = pHandle->pParams_str->TIMx;

  pHandle->PhaseAOffset = 0u;
  pHandle->PhaseBOffset = 0u;
  pHandle->PhaseCOffset = 0u;

  pHandle->PolarizationCounter = 0u;

  /* It forces inactive level on TIMx CHy and CHyN */
  LL_TIM_CC_DisableChannel(TIMx, TIMxCCER_MASK_CH123);

  /* Offset calibration for all phases */
  /* Change function to be executed in ADCx_ISR */
  __disable_irq();
  pHandle->_Super.pFctGetPhaseCurrents = &R3_2_HFCurrentsPolarizationAB;
  pHandle->_Super.pFctSetADCSampPointSectX = &R3_2_SetADCSampPointPolarization;
  pHandle->ADCTriggerEdge = (uint16_t) LL_ADC_INJ_TRIG_EXT_RISING;
     
  /* We want to polarize calibration Phase A and Phase B, so we select SECTOR_5 */
  pHandle->PolarizationSector=SECTOR_5;
  /* Required to force first polarization conversion on SECTOR_5*/
  pHandle->_Super.Sector = SECTOR_5;   
  __enable_irq();

  R3_2_SwitchOnPWM( &pHandle->_Super );
  
  /* Wait for NB_CONVERSIONS to be executed */
  while ( pHandle->PolarizationCounter < NB_CONVERSIONS )
  { }

  R3_2_SwitchOffPWM( &pHandle->_Super );
  
  /* Offset calibration for C phase */
  pHandle->PolarizationCounter = 0u;
  
  /* Change function to be executed in ADCx_ISR */
  __disable_irq();
  pHandle->_Super.pFctGetPhaseCurrents = &R3_2_HFCurrentsPolarizationC;
  /* We want to polarize Phase C, so we select SECTOR_1 */
  pHandle->PolarizationSector=SECTOR_1;
  /* Required to force first polarization conversion on SECTOR_1*/
  pHandle->_Super.Sector = SECTOR_1;   
  __enable_irq();
  R3_2_SwitchOnPWM( &pHandle->_Super );

  /* Wait for NB_CONVERSIONS to be executed */
  while ( pHandle->PolarizationCounter < NB_CONVERSIONS )
  { }
  
  R3_2_SwitchOffPWM( &pHandle->_Super );
  pHandle->PhaseAOffset /= NB_CONVERSIONS;
  pHandle->PhaseBOffset /= NB_CONVERSIONS;
  pHandle->PhaseCOffset /= NB_CONVERSIONS;

  /* Change back function to be executed in ADCx_ISR */
  __disable_irq();
  pHandle->_Super.pFctGetPhaseCurrents = &R3_2_GetPhaseCurrents;
  pHandle->_Super.pFctSetADCSampPointSectX = &R3_2_SetADCSampPointSectX;
  __enable_irq();

  /* Disable TIMx preload */
  LL_TIM_OC_DisablePreload(TIMx, LL_TIM_CHANNEL_CH1);
  LL_TIM_OC_DisablePreload(TIMx, LL_TIM_CHANNEL_CH2);
  LL_TIM_OC_DisablePreload(TIMx, LL_TIM_CHANNEL_CH3);
  /* It over write TIMx CCRy wrongly written by FOC during calibration so as to
     force 50% duty cycle on the three inverer legs */
  LL_TIM_OC_SetCompareCH1 (TIMx, pHandle->Half_PWMPeriod >> 1u);
  LL_TIM_OC_SetCompareCH2 (TIMx, pHandle->Half_PWMPeriod >> 1u);
  LL_TIM_OC_SetCompareCH3 (TIMx, pHandle->Half_PWMPeriod >> 1u);
  /* Apply new CC values */
  LL_TIM_OC_EnablePreload(TIMx, LL_TIM_CHANNEL_CH1);
  LL_TIM_OC_EnablePreload(TIMx, LL_TIM_CHANNEL_CH2);
  LL_TIM_OC_EnablePreload(TIMx, LL_TIM_CHANNEL_CH3);

  /* It re-enable drive of TIMx CHy and CHyN by TIMx CHyRef*/
  LL_TIM_CC_EnableChannel(TIMx, TIMxCCER_MASK_CH123);
  
  /* At the end of calibration, all phases are at 50% we will sample A&B */
  pHandle->_Super.Sector=SECTOR_5;
  
  pHandle->_Super.BrakeActionLock = false;

}

#if defined (CCMRAM)
#if defined (__ICCARM__)
#pragma location = ".ccmram"
#elif defined (__CC_ARM) || defined(__GNUC__)
__attribute__( ( section ( ".ccmram" ) ) )
#endif
#endif
/*
  * @brief  Computes and stores in @p pHdl handler the latest converted motor phase currents in @p Iab ab_t format.
  *
  */
__weak void R3_2_GetPhaseCurrents( PWMC_Handle_t * pHdl, ab_t * Iab )
{
#if defined (__ICCARM__)
  #pragma cstat_disable = "MISRAC2012-Rule-11.3"
#endif /* __ICCARM__ */
  PWMC_R3_2_Handle_t * pHandle = ( PWMC_R3_2_Handle_t * )pHdl;  
#if defined (__ICCARM__)
  #pragma cstat_restore = "MISRAC2012-Rule-11.3"
#endif /* __ICCARM__ */
  TIM_TypeDef * TIMx = pHandle->pParams_str->TIMx;

  uint8_t Sector;
  int32_t Aux;
  uint32_t ADCDataReg1;
  uint32_t ADCDataReg2;
  
  Sector = ( uint8_t )pHandle->_Super.Sector;
  ADCDataReg1 = pHandle->pParams_str->ADCDataReg1[Sector]->JDR1;
  ADCDataReg2 = pHandle->pParams_str->ADCDataReg2[Sector]->JDR1;
  
  /* disable ADC trigger source */
  //LL_TIM_CC_DisableChannel(TIMx, LL_TIM_CHANNEL_CH4);  
  LL_TIM_SetTriggerOutput(TIMx, LL_TIM_TRGO_RESET);
  
  switch ( Sector )
  {
    case SECTOR_4:
    case SECTOR_5:
      /* Current on Phase C is not accessible     */
      /* Ia = PhaseAOffset - ADC converted value) */
      Aux = ( int32_t )( pHandle->PhaseAOffset ) - ( int32_t )( ADCDataReg1 );

      /* Saturation of Ia */
      if ( Aux < -INT16_MAX )
      {
        Iab->a = -INT16_MAX;
      }
      else  if ( Aux > INT16_MAX )
      {
        Iab->a = INT16_MAX;
      }
      else
      {
        Iab->a = ( int16_t )Aux;
      }

      /* Ib = PhaseBOffset - ADC converted value) */
      Aux = ( int32_t )( pHandle->PhaseBOffset ) - ( int32_t )( ADCDataReg2 );

      /* Saturation of Ib */
      if ( Aux < -INT16_MAX )
      {
        Iab->b = -INT16_MAX;
      }
      else  if ( Aux > INT16_MAX )
      {
        Iab->b = INT16_MAX;
      }
      else
      {
        Iab->b = ( int16_t )Aux;
      }
      break;

    case SECTOR_6:
    case SECTOR_1:
      /* Current on Phase A is not accessible     */
      /* Ib = PhaseBOffset - ADC converted value) */
      Aux = ( int32_t )( pHandle->PhaseBOffset ) - ( int32_t )( ADCDataReg1 );

      /* Saturation of Ib */
      if ( Aux < -INT16_MAX )
      {
        Iab->b = -INT16_MAX;
      }
      else  if ( Aux > INT16_MAX )
      {
        Iab->b = INT16_MAX;
      }
      else
      {
        Iab->b = ( int16_t )Aux;
      }

      /* Ia = -Ic -Ib */
      Aux = ( int32_t )( ADCDataReg2 ) - ( int32_t )( pHandle->PhaseCOffset ); /* -Ic */
      Aux -= ( int32_t )Iab->b;             /* Ia  */

      /* Saturation of Ia */
      if ( Aux > INT16_MAX )
      {
        Iab->a = INT16_MAX;
      }
      else  if ( Aux < -INT16_MAX )
      {
        Iab->a = -INT16_MAX;
      }
      else
      {
        Iab->a = ( int16_t )Aux;
      }
      break;

    case SECTOR_2:
    case SECTOR_3:
      /* Current on Phase B is not accessible     */
      /* Ia = PhaseAOffset - ADC converted value) */
      Aux = ( int32_t )( pHandle->PhaseAOffset ) - ( int32_t )( ADCDataReg1 );

      /* Saturation of Ia */
      if ( Aux < -INT16_MAX )
      {
        Iab->a = -INT16_MAX;
      }
      else  if ( Aux > INT16_MAX )
      {
        Iab->a = INT16_MAX;
      }
      else
      {
        Iab->a = ( int16_t )Aux;
      }

      /* Ib = -Ic -Ia */
      Aux = ( int32_t )( ADCDataReg2 ) - ( int32_t )( pHandle->PhaseCOffset ); /* -Ic */
      Aux -= ( int32_t )Iab->a;             /* Ib */

      /* Saturation of Ib */
      if ( Aux > INT16_MAX )
      {
        Iab->b = INT16_MAX;
      }
      else  if ( Aux < -INT16_MAX )
      {
        Iab->b = -INT16_MAX;
      }
      else
      {
        Iab->b = ( int16_t )Aux;
      }
      break;

    default:
      break;
  }

  pHandle->_Super.Ia = Iab->a;
  pHandle->_Super.Ib = Iab->b;
  pHandle->_Super.Ic = -Iab->a - Iab->b;
}

/*
  * @brief  Computes and stores in @p pHdl handler the latest converted motor phase currents in @p Iab ab_t format. Specific to overmodulation.
  *
  */
__weak void R3_2_GetPhaseCurrents_OVM( PWMC_Handle_t * pHdl, ab_t * Iab )
{
#if defined (__ICCARM__)
  #pragma cstat_disable = "MISRAC2012-Rule-11.3"
#endif /* __ICCARM__ */
  PWMC_R3_2_Handle_t * pHandle = ( PWMC_R3_2_Handle_t * )pHdl;
#if defined (__ICCARM__)
  #pragma cstat_restore = "MISRAC2012-Rule-11.3"
#endif /* __ICCARM__ */
  TIM_TypeDef * TIMx = pHandle->pParams_str->TIMx;

  uint8_t Sector;
  int32_t Aux;
  uint32_t ADCDataReg1;
  uint32_t ADCDataReg2;

    /* Disable ADC trigger source */
    LL_TIM_SetTriggerOutput(TIMx, LL_TIM_TRGO_RESET);

  Sector = ( uint8_t )pHandle->_Super.Sector;
  ADCDataReg1 = pHandle->pParams_str->ADCDataReg1[Sector]->JDR1 * 2;
  ADCDataReg2 = pHandle->pParams_str->ADCDataReg2[Sector]->JDR1 * 2;

switch ( Sector )
  {
    case SECTOR_4:
      /* Current on Phase C is not accessible     */
      /* Ia = PhaseAOffset - ADC converted value) */
      Aux = ( int32_t )( pHandle->PhaseAOffset ) - ( int32_t )( ADCDataReg1 );

      /* Saturation of Ia */
      if ( Aux < -INT16_MAX )
      {
        Iab->a = -INT16_MAX;
      }
      else  if ( Aux > INT16_MAX )
      {
        Iab->a = INT16_MAX;
      }
      else
      {
        Iab->a = ( int16_t )Aux;
      }

      if (pHandle->_Super.useEstCurrent == true)
      {
        // Ib not available, use estimated Ib
        Aux = ( int32_t )( pHandle->_Super.IbEst );
      }
      else
      {
        /* Ib = PhaseBOffset - ADC converted value) */
        Aux = ( int32_t )( pHandle->PhaseBOffset ) - ( int32_t )( ADCDataReg2 );
      }

      /* Saturation of Ib */
      if ( Aux < -INT16_MAX )
      {
        Iab->b = -INT16_MAX;
      }
      else  if ( Aux > INT16_MAX )
      {
        Iab->b = INT16_MAX;
      }
      else
      {
        Iab->b = ( int16_t )Aux;
      }
      break;

    case SECTOR_5:
      /* Current on Phase C is not accessible     */
      /* Ia = PhaseAOffset - ADC converted value) */
      if (pHandle->_Super.useEstCurrent == true)
      {
        // Ia not available, use estimated Ia
        Aux = ( int32_t )( pHandle->_Super.IaEst );
      }
      else
      {
        Aux = ( int32_t )( pHandle->PhaseAOffset ) - ( int32_t )( ADCDataReg1 );
      }

      /* Saturation of Ia */
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
      }
      else
      {
        Iab->b = ( int16_t )Aux;
      }
      break;
    case SECTOR_3:
      /* Current on Phase B is not accessible     */
      /* Ia = PhaseAOffset - ADC converted value) */
      Aux = ( int32_t )( pHandle->PhaseAOffset ) - ( int32_t )( ADCDataReg1 );

      /* Saturation of Ia */
      if ( Aux < -INT16_MAX )
      {
        Iab->a = -INT16_MAX;
      }
      else  if ( Aux > INT16_MAX )
      {
        Iab->a = INT16_MAX;
      }
      else
      {
        Iab->a = ( int16_t )Aux;
      }

      if (pHandle->_Super.useEstCurrent == true)
      {
        /* Ib = -Ic -Ia */
        Aux = ( int32_t ) pHandle->_Super.IcEst; /* -Ic */
        Aux -= ( int32_t )Iab->a;             /* Ib */
      }
      else
      {
        /* Ib = -Ic -Ia */
        Aux = ( int32_t )( ADCDataReg2 ) - ( int32_t )( pHandle->PhaseCOffset ); /* -Ic */
        Aux -= ( int32_t )Iab->a;             /* Ib */
      }

      /* Saturation of Ib */
      if ( Aux > INT16_MAX )
      {
        Iab->b = INT16_MAX;
      }
      else  if ( Aux < -INT16_MAX )
      {
        Iab->b = -INT16_MAX;
      }
      else
      {
        Iab->b = ( int16_t )Aux;
      }
      break;

    default:
      break;
  }

    pHandle->_Super.Ia = Iab->a;
    pHandle->_Super.Ib = Iab->b;
    pHandle->_Super.Ic = -Iab->a - Iab->b;
}

#if defined (CCMRAM)
#if defined (__ICCARM__)
#pragma location = ".ccmram"
#elif defined (__CC_ARM) || defined(__GNUC__)
__attribute__( ( section ( ".ccmram" ) ) )
#endif
#endif
/*
  * @brief  Configures the ADC for the current sampling during calibration.
  * 
  * It sets the ADC sequence length and channels, and the sampling point via TIMx_Ch4 value and polarity.
  * It then calls the WriteTIMRegisters method.
  *
  * @param  pHdl: Handler of the current instance of the PWM component.
  * @retval Return value of R3_2_WriteTIMRegisters.
  */
uint16_t R3_2_SetADCSampPointPolarization( PWMC_Handle_t * pHdl )
{
#if defined (__ICCARM__)
  #pragma cstat_disable = "MISRAC2012-Rule-11.3"
#endif /* __ICCARM__ */
  PWMC_R3_2_Handle_t * pHandle = ( PWMC_R3_2_Handle_t * )pHdl;
#if defined (__ICCARM__)
  #pragma cstat_restore = "MISRAC2012-Rule-11.3"
#endif /* __ICCARM__ */
  pHandle->_Super.Sector = pHandle->PolarizationSector;

  return R3_2_WriteTIMRegisters( &pHandle->_Super, ( pHandle->Half_PWMPeriod - (uint16_t) 1 ) );
}

#if defined (CCMRAM)
#if defined (__ICCARM__)
#pragma location = ".ccmram"
#elif defined (__CC_ARM) || defined(__GNUC__)
__attribute__( ( section ( ".ccmram" ) ) )
#endif
#endif
/*
  * @brief  Configures the ADC for the current sampling related to sector X (X = [1..6] ).
  * 
  * Sets the ADC sequence length and channels and sets the sampling point via TIMx_Ch4 value and polarity.
  * The WriteTIMRegisters method is then called.
  * 
  * @param  pHdl: Handler of the current instance of the PWM component.
  * @retval uint16_t Returns the value of R3_2_WriteTIMRegisters.
  */
uint16_t R3_2_SetADCSampPointSectX( PWMC_Handle_t * pHdl )
{
#if defined (__ICCARM__)
  #pragma cstat_disable = "MISRAC2012-Rule-11.3"
#endif /* __ICCARM__ */
  PWMC_R3_2_Handle_t * pHandle = ( PWMC_R3_2_Handle_t * )pHdl;
#if defined (__ICCARM__)
  #pragma cstat_restore = "MISRAC2012-Rule-11.3"
#endif /* __ICCARM__ */

  uint16_t SamplingPoint;
  uint16_t DeltaDuty;
  
  /* Check if sampling the AB phases in the middle of the PWM period is possible */
  if ( ( uint16_t )( pHandle->Half_PWMPeriod - pHdl->lowDuty ) > pHandle->pParams_str->Tafter )
  {
    /* When it is possible to sample in the middle of the PWM period, always sample the same phases
     * (AB are chosen) for all sectors in order to not induce current discontinuities when there are
     * differences between offsets */

    /* Sector number needed by GetPhaseCurrent, phase A and B are sampled which corresponds to 
     * sector 4 or 5 */
    pHandle->_Super.Sector = SECTOR_5;

    /* Set the sampling point in the middle of the PWM period */
    SamplingPoint = pHandle->Half_PWMPeriod - 1u;
  }
  else
  {
    /* In this case it is necessary to sample phases with maximum and variable complementary duty cycle */

    /* In every sector there is always one phase with maximum complementary duty, one with minimum 
     * complementary duty and one with variable complementary duty. In this case, phases with variable 
     * and maximum complementary duty are converted, always starting with the one with variable 
     * complementary duty cycle */

    DeltaDuty = ( uint16_t )( pHdl->lowDuty - pHdl->midDuty );

    /* Definition of crossing point */
    if ( DeltaDuty > ( uint16_t )( pHandle->Half_PWMPeriod - pHdl->lowDuty ) * 2u )
    {
      SamplingPoint = pHdl->lowDuty - pHandle->pParams_str->Tbefore;
    }
    else
    {
      SamplingPoint = pHdl->lowDuty + pHandle->pParams_str->Tafter;

      if ( SamplingPoint >= pHandle->Half_PWMPeriod )
      {
         /* ADC trigger edge must be changed from positive to negative */
        pHandle->ADCTriggerEdge = LL_ADC_INJ_TRIG_EXT_FALLING;
        SamplingPoint = ( 2u * pHandle->Half_PWMPeriod ) - SamplingPoint - (uint16_t) 1;
      }
    }
  }
  return R3_2_WriteTIMRegisters( &pHandle->_Super, SamplingPoint );
}

/*
  * @brief  Configures the ADC for the current sampling related to sector X (X = [1..6] ) in case of overmodulation.
  * 
  * Sets the ADC sequence length and channels and sets the sampling point via TIMx_Ch4 value and polarity.
  * The WriteTIMRegisters method is then called.
  * 
  * @param  pHdl: Handler of the current instance of the PWM component.
  * @retval uint16_t Returns the value of R3_2_WriteTIMRegisters.
  */
uint16_t R3_2_SetADCSampPointSectX_OVM( PWMC_Handle_t * pHdl )
{
#if defined (__ICCARM__)
#pragma cstat_disable = "MISRAC2012-Rule-11.3"
#endif /* __ICCARM__ */
  PWMC_R3_2_Handle_t * pHandle = ( PWMC_R3_2_Handle_t * )pHdl;
#if defined (__ICCARM__)
#pragma cstat_restore = "MISRAC2012-Rule-11.3"
#endif /* __ICCARM__ */

  uint16_t SamplingPoint;
  uint16_t DeltaDuty;

  pHandle->_Super.useEstCurrent = false;
  DeltaDuty = ( uint16_t )( pHdl->lowDuty - pHdl->midDuty );

  /* Check if sampling the AB phases in the middle of the PWM period is possible */
  if ( ( uint16_t )( pHandle->Half_PWMPeriod - pHdl->lowDuty ) > pHandle->pParams_str->Tafter )
  {
	  /* When it is possible to sample in the middle of the PWM period, always sample the same phases
	   * (AB are chosen) for all sectors in order to not induce current discontinuities when there are differences
	   * between offsets */

	  /* Sector number needed by GetPhaseCurrent, phase A and B are sampled which corresponds
	   * to sector 4 or 5  */
    pHandle->_Super.Sector = SECTOR_5;

    /* Set the sampling point in the middle of the PWM period */
    SamplingPoint =  pHandle->Half_PWMPeriod - 1u;
  }
  else
  {
    /* In this case it is necessary to sample phases with maximum and variable complementary duty cycle.*/

    /* In every sector there is always one phase with maximum complementary duty, one with minimum 
     * complementary duty and one with variable complementary duty. In this case, phases with variable
     * complementary duty and with maximum duty are converted and the first will be always the phase
     * with variable complementary duty cycle */

    if ( DeltaDuty >= pHandle->pParams_str->Tcase3 )
    {
      SamplingPoint = pHdl->lowDuty - pHandle->pParams_str->Tbefore;
    }
    else
    {
      /* case 2 (cf user manual) */
      if ( ( pHandle->Half_PWMPeriod - pHdl->lowDuty ) > pHandle->pParams_str->Tcase2 )
      {
        /* ADC trigger edge must be changed from positive to negative */
        pHandle->ADCTriggerEdge = (uint16_t) LL_ADC_INJ_TRIG_EXT_FALLING;
        SamplingPoint = pHdl->lowDuty + pHandle->pParams_str->Tbefore;
      }
      else
      {
        /* No suitable sampling window has been found, sampling is executed in the middle of the PWM
         * Period. Sampled currents will be disregarded and estimated currents will be used instead */
        SamplingPoint = pHandle->Half_PWMPeriod - 1u;
        pHandle->_Super.useEstCurrent = true;

      }
    }
  }
  return R3_2_WriteTIMRegisters( &pHandle->_Super, SamplingPoint );
}

#if defined (CCMRAM)
#if defined (__ICCARM__)
#pragma location = ".ccmram"
#elif defined (__CC_ARM) || defined(__GNUC__)
__attribute__( ( section ( ".ccmram" ) ) )
#endif
#endif
/*
  * @brief  Writes into peripheral registers the new duty cycle and sampling point.
  *
  * @param  pHdl: Handler of the current instance of the PWM component.
  * @param  SamplingPoint: Point at which the ADC will be triggered, written in timer clock counts.
  * @retval Returns #MC_NO_ERROR if no error occurred or #MC_DURATION if the duty cycles were
  *         set too late for being taken into account in the next PWM cycle.
  */
__STATIC_INLINE uint16_t R3_2_WriteTIMRegisters( PWMC_Handle_t * pHdl, uint16_t SamplingPoint )
{
#if defined (__ICCARM__)
  #pragma cstat_disable = "MISRAC2012-Rule-11.3"
#endif /* __ICCARM__ */
  PWMC_R3_2_Handle_t * pHandle = ( PWMC_R3_2_Handle_t * )pHdl;
#if defined (__ICCARM__)
  #pragma cstat_restore = "MISRAC2012-Rule-11.3"
#endif /* __ICCARM__ */
  TIM_TypeDef * TIMx = pHandle->pParams_str->TIMx;
  uint16_t Aux;


  LL_TIM_OC_SetCompareCH1 ( TIMx, (uint32_t) pHandle->_Super.CntPhA );
  LL_TIM_OC_SetCompareCH2 ( TIMx, (uint32_t) pHandle->_Super.CntPhB );
  LL_TIM_OC_SetCompareCH3 ( TIMx, (uint32_t) pHandle->_Super.CntPhC );
  LL_TIM_OC_SetCompareCH4( TIMx, (uint32_t) SamplingPoint );

  /* Limit for update event */

//  if ( LL_TIM_CC_IsEnabledChannel(TIMx, LL_TIM_CHANNEL_CH4) == 1u )
  if (((TIMx->CR2) & TIM_CR2_MMS_Msk) != LL_TIM_TRGO_RESET )
  {
    Aux = MC_DURATION;
  }
  else
  {
    Aux = MC_NO_ERROR;
  }
  return Aux;
}
/*
  * @brief  Implementation of PWMC_GetPhaseCurrents to be performed during polarization.
  * 
  * It sums up injected conversion data into PhaseAOffset and
  * PhaseBOffset to compute the offset introduced in the current feedback
  * network. It is required to properly configure ADC inputs before in order to enable
  * the offset computation.
  *
  * @param  pHdl: Handler of the current instance of the PWM component.
  * @param  Iab: Pointer to the structure that will receive motor current
  *         of phase A and B in ab_t format.
  */
static void R3_2_HFCurrentsPolarizationAB( PWMC_Handle_t * pHdl, ab_t * Iab )
{
#if defined (__ICCARM__)
  #pragma cstat_disable = "MISRAC2012-Rule-11.3"
#endif /* __ICCARM__ */
  PWMC_R3_2_Handle_t * pHandle = ( PWMC_R3_2_Handle_t * )pHdl;
#if defined (__ICCARM__)
  #pragma cstat_restore = "MISRAC2012-Rule-11.3"
#endif /* __ICCARM__ */
  TIM_TypeDef * TIMx = pHandle->pParams_str->TIMx;
  uint32_t ADCDataReg1 = pHandle->pParams_str->ADCDataReg1[pHandle->PolarizationSector]->JDR1;
  uint32_t ADCDataReg2 = pHandle->pParams_str->ADCDataReg2[pHandle->PolarizationSector]->JDR1;
   
  /* disable ADC trigger source */
  //LL_TIM_CC_DisableChannel(TIMx, LL_TIM_CHANNEL_CH4);
    LL_TIM_SetTriggerOutput(TIMx, LL_TIM_TRGO_RESET);

  if ( pHandle->PolarizationCounter < NB_CONVERSIONS )
  {
    pHandle-> PhaseAOffset += ADCDataReg1;
    pHandle-> PhaseBOffset += ADCDataReg2;
    pHandle->PolarizationCounter++;
  }

  /* during offset calibration no current is flowing in the phases */
  Iab->a = 0;
  Iab->b = 0;
}
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
