vsimhas/CPAP_Micronel/(commit log)

2026-06-12 Including diagnostic screen and PID for blower pressure control
2026-06-16 Including blower based oscillation and flow sensing code
2026-06-17 Before generating code for trace
2026-06-17 After PID tuning with fopdt
2026-06-18 Temp commit before switching to 330 mohm
2026-06-24 Enabling tube comp and other changes
2026-06-26 Including blower speed/torque PID controls in py application
2026-07-14 Combo flow element and Vivo leak estimation faster update
2026-08-28 Additional filtering after breath completion. Need to check if its needed or not once again
2026-09-03 Waveform bench A/B: PS staleness guard, expiratory floor switches, live deadband
    Three changes aimed at the CPAP pressure waveform, all verified with
    arm-none-eabi-gcc -fsyntax-only -Wall -Wextra.
    1. Pressure-sample staleness (the 10 Hz derivative artefact)
    SPI4 is shared between the pressure and ambient sensors, so measPS is not
    refreshed on every 5 ms tick: one tick in AS_DECIMATE goes to AS, and a
    busy/torn conversion can hold the previous sample too. BlowerCtrl_Step was
    dividing an unchanged sample by one tick period, producing a derivative of
    zero followed by a doubled one - a periodic disturbance at 10 Hz into both
    d_term and the dip-FF drop rate, and from there into the RPM command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
2026-09-03 Fix runaway: never gate the PID feedback level on sample freshness
    Regression from ba53294. Therapy ran to ~20 cmH2O against an 8 cmH2O
    target, then the safety supervisor faulted and dropped output to 0.
    Cause: ba53294 marked a PS sample "fresh" only when AMS5935_WasSampleHeld()
    was clear, and gated the measurement IIR on that flag. But PS runs a 1-tick
    pipeline (5 ms) against a ~4 ms conversion with no EOC line - the same
    margin problem that gave the flow sensor FS_CONV_TICKS = 2 - so ReadRaw
    frequently returns a held sample. A held read still carries the last good
    pressure and was always accepted before. Rejecting it stalled
    s_meas_filt_cmh2o, the PID's feedback level, so the loop ran ope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
2026-09-04 Initial flow limitation detection working
2026-09-24 Fix power-stage calibration; stop mask-off firing on ordinary breaths
    Bench work at 18 cmH2O with a human breathing turned up a chain of
    calibration errors, all of them X-NUCLEO-IHM16M1 defaults left in place
    on custom hardware.
    Bus voltage sensing
    VBUS_PARTITIONING_FACTOR 0.0625 -> 0.05543. The schematic divider is
    R137 180K / R138 12K = 0.0625, but the fitted board measures 1.323 V at
    the V_MOT node with V_MOTOR at 23.87 V, so the real ratio is 0.05543.
    A 10.5K appears to be fitted where the BOM says 12K.
    This was not just a reporting error. The raw ADC word feeds the
    sensorless observer (STO_Inputs.Vbus), which reconstructs applied phase
    voltage from it, so every rpm this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
2026-09-24 Re-derive blower pressure model; split c_fan DC from dynamic response
    The four feed-forward constants are one calibration and move together:
    c_fan was fitted using this K and offset.
    ff_k 6141 -> 6731
    ff_offset 1820 -> 796
    ff_offset_slope 157 -> 0
    physics_ff_c_fan 0.0003 -> 0.000683
    flow LPF 12/10 Hz -> 3 Hz
    Steady-state model: six-point setpoint sweep, 6-20 cmH2O, validated by
    pre-loading the fit and confirming the integrator then carried nothing
    (|I| <= 110 rpm at every setpoint, residuals +/-24 rpm). The old constants
    over-asked by ~1300 rpm everywhere. The offset slope is dropped: it was
    standing in for flow dependence c_fan was too small to ca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
2026-09-24 Disable the regen brake until its thresholds can be set properly
    BRAKE_VBUS_ON_V 22 -> 26, i.e. above the supply, so the brake cannot arm.
    This is a regression fix. The thresholds were set against the mis-scaled
    bus reading, when a real 23.9 V bus reported 20-21 V, so 22 was above
    anything seen and the brake never armed in practice. Correcting
    VBUS_PARTITIONING_FACTOR (d7fb050) made the same bus report 23. The first
    deceleration then latched the brake, and it never released: release needs
    vbus <= 21, which a 23.9 V supply never reaches. Result was 250 permille
    continuous into R154 - about 5.7 W of standing heat in a 25 W resistor -
    found because the resistor got hot, not by anything in firm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
2026-09-24 Enable FOC over-modulation behind a compile switch (on)
    FOC_OVERMODULATION_ENABLE selects PWMC_SetPhaseVoltage_OVM in place of
    PWMC_SetPhaseVoltage at the one call site in mc_tasks_foc.c. The OVM
    source is copied from the MCSDK into CM4/Core/Src and added to both Keil
    targets, matching how the other SDK sources enter this build.
    Why: the drive is back-EMF limited. Measured in ST Motor Pilot, the rotor
    plateaus at 37700 rpm on a 23.9 V bus with Iq at only 58-65% of its
    limit. Over-modulation raises the achievable fundamental from 0.707 to up
    to 0.780 of Vbus. Bench result: 41000 rpm, where the STSPIN830 raises
    Driver Protection - its over-current comparator seeing ripple, which at
    Ls 70 uH /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
2026-09-24 Flow sensor: report full scale on over-range instead of freezing
    The flow ΔP sensor is an AMS5935 at ±5 mbar, which the flow LUT ends at
    ~93 slm. Past that it flags overflow. The driver treated overflow like a
    torn or busy read and returned the last good sample indefinitely, so
    Flow_Update was never called and the published flow froze at whatever
    value it had reached on the way up - 26.2, 40.7 and 52.6 slm on three
    bench runs, the spread coming from the 6 slm/sample impulse cap.
    Overflow means flow is AT LEAST ~93 slm; the firmware was publishing a
    number far below that. A mask disconnect at high pressure is exactly a
    fast step past full scale, and the frozen value can sit under the mask-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
2026-09-24 Telemetry: raw flow and flow-sensor guard state on the B line
    Appends to the opt-in B line (blower set telem_motor 1, 25 Hz):
    q_total Flow_GetSlm(), raw total device flow
    dp_raw ΔP as read, before the slew guard
    slew_rej cumulative slew-guard rejects
    stale this tick's flow sample was dropped
    stale_run consecutive dropped samples
    sat this tick's flow sample was clipped to full scale
    sat_n cumulative clipped samples
    q_total exists because nothing else on the stream carried raw total flow.
    The D line's q_filt is the physics feed-forward's own filtered copy, and
    the FF only runs in therapy: in open-loop manual mode q_filt was measured
    holding 45.7 slm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
2026-09-24 CM4: acknowledge before stopping, and check that the stop took
    MCI_StopMotor refuses while any fault is latched (PastFaults or
    CurrentFaults) and in IDLE; MCI_FaultAcknowledged only acts in FAULT_OVER.
    The STOP handler stopped first and acknowledged second, discarding both
    results, so a STOP that arrived in FAULT_OVER was refused and only the
    acknowledge that followed it made the next STOP possible. Now it
    acknowledges first, then stops, and checks the return.
    If the stop is refused while the drive is still POWERING the motor (RUN,
    START, SWITCH_OVER, ALIGNMENT, CHARGE_BOOT_CAP, OFFSET_CALIB), it raises
    MC_SW_ERROR through MCI_FaultProcessing - the SDK's own software-error
    stop, the same ca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
2026-09-24 Telemetry: CM4 occurred-fault bits on the B line
    Appends occ_faults (g_blower_status.occurred_faults, MC_* codes from
    mc_type.h) to the opt-in B line.
    It is the field that would have explained the 34000 rpm "blower that
    would not stop": with it, a fault at speed shows as mc_state 10/11 and
    non-zero occ_faults, instead of only a mech_rpm that keeps reading the
    last speed. Read it together with mc_state - the speed estimator is
    disabled in IDLE, FAULT_NOW and FAULT_OVER, so mech_rpm is not evidence
    that the power stage is on.
2026-09-24 Blower FF: joint fit of K, offset and c_fan (6535 / 853 / 0.001634)
    K, offset and c_fan had been fitted in separate flow regimes, so each
    absorbed the others' error. A joint fit over 22 steady points (0 to 80+
    slm, 4 to 20 cmH2O) gives 0.10 cmH2O rms. Steady rpm error drops from up
    to 2228 to 154, and at breath peaks from -2739 to +493. Also corrects the
    comment that subtracted R_turb from c_fan.
    Human breathing on the normal circuit: median sag 1.13 cmH2O at 18,
    1.19 at 20 (worst 2.46), no mask-off events, no faults.
    therapy.c: mark the rpm-ratio mask-off margin note stale against the new
    model, and record the re-measured margin at 18 and 20 cmH2O (51% / 52%).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
2026-09-24 Blower ctrl: headroom clamp holds the integrator instead of dragging it
    The clamp to remaining rpm headroom set I <= rpm_max - FF - P - D. When
    FF + P alone exceeded the 40000 ceiling - every inspiratory peak at 20
    cmH2O - the bound went negative and pulled I to its -4000 limit while the
    pressure error was positive. The negative I outlived the peak: it held
    back ~1200 rpm for 0.5-1.4 s after peak flow and wiped the ~+750 rpm
    steady trim every breath.
    The clamp now stops I growing into saturation but never pushes it past
    its previous value; the low side is symmetric. Output limits unchanged.
    Inert whenever FF + P + D stays inside [0, 40000], i.e. at <= ~12 cmH2O.
    Human breathing at 20 cmH2O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
2026-09-25 Mask-off hardening and CM4 restart-while-coasting guard
    Mask-off flow fast path (therapy.c, blower_ctrl, flow_sensor, main.c):
    - At 20 cmH2O with the ceiling cut to 38500, a big inspiration (flow
    clipped at 89.1 slm, P_sensor 17.77, P_mask 15.85) held the relative
    pressure gate for exactly the 600 ms confirm and parked the blower.
    - Clipped flow, or a PID at its upper limit, now arms the fast path
    only if BOTH pressures are below min(abs_floor, sp - drop). The floor
    test also needs a real shortfall, so 3.9 at a 4 cmH2O target no
    longer counts. Nonfinite flow, or flow never received, never arms.
    - A held flow read only invalidates the flow after more than
    flow_stale_ticks_max (6 t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
2026-09-25 Mask-off: sensor-side open-circuit floor and no flow-only false reconnect
    Sensor-side floor (fast path at 20 cmH2O):
    - The clipped-flow / upper-limited exception needed BOTH pressures under
    4.0. At 20 cmH2O the device-side sensor still reads the hose drop at
    open-circuit flow (3.5-5.1 once open) while the mask estimate floors
    (2.1-3.2), so real pulls fell through to rpm-ratio at ~2.5 s.
    - New maskOffOpenCircuitPressure(): mask estimate < min(4.0, sp - drop),
    sensor < min(4.0 + press_sensor_allow, sp - drop), allowance 2.5.
    The 300 ms strong-open shortcut keeps the single 4.0 floor.
    - The false trigger this guards against had P_sensor 17.77; breathing
    at 20 never took the sensor b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
2026-09-25 Tube comp: apply the calibrated coefficients at boot; freeze the FF hose basis
    TubeComp_Init() reset R_lam / R_turb to the old 0.002 / 0.00022, so the
    2026-09-22 mask-end fit (0.00353 / 0.000118) only applied in sessions
    that set it over USB. The D-line hose term shows every 2026-09-24
    capture ran on the old pair, including the joint FF fit, the sag runs
    and the mask-pull tuning. One definition now feeds both the initialisers
    and TubeComp_Init().
    The physics FF hose term read the same coefficients, but the joint fit
    of K / offset / c_fan (6535 / 853 / 0.001634) was made on the old pair
    and only hose + c_fan*Q^2 together is calibrated. The FF now has its own
    coefficients, frozen at 0.002 / 0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
2026-10-01 Breathing-dependent over-pressure threshold; Vd/Vq on the B telemetry line
    Over-pressure threshold (CM7, blower_ctrl.c):
    - The 6x over-pressure P boost and the overpressure brake share one
    threshold. At rest it is now 0.30 cmH2O (was 0.12); while the patient
    breathes it is 0.12, held for 10 s after the end of each real inhalation
    (>= 0.3 s and >= 8 L/min, so flow-noise flicker of the inhaling flag
    never arms it).
    - Why: at rest 0.12 was crossed by sensor noise, adding rotor jitter. While
    breathing, an A/B at 20 cmH2O (simulator, 2 x 60 s blocks each, port
    pressure 5 Hz low-pass) gave breath p-p 0.76 / fast sd 0.129 with 0.12,
    0.94 / 0.153 with 0.30, and 0.83 / 0.126 with the br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
2026-10-01 blower_ctrl: note that the rest-noise figures came from a faulty setup
    The 0.12 -> 0.30 rationale quotes rest error noise of 0.07-0.09 cmH2O,
    measured on 2026-09-30 with a fault in the blower-to-flow-element air path.
    On the restored circuit it was 0.018-0.025 cmH2O. Comment only.
2026-10-01 GUI: tuning defaults match the firmware; add over-pressure threshold fields
    "Apply" sends every tuning field, so stale GUI defaults overwrote the
    firmware on each apply. Brought into line with CM7/CM4 defaults:
    - rpm_max 30000 -> 43000 (BLOWER_IPC_MAX_SPEED_RPM). 30000 capped the
    pressure loop below what 20 cmH2O needs with the original inlet.
    - FOC speed_ki 256 -> 1024 (drive_parameters.h since 2026-09-25).
    - Tube comp R_lam/R_turb 0.002/0.00022 -> 0.00353/0.000118, the calibrated
    values; the old pair is the frozen physics-FF hose basis and re-created
    the tube-comp mismatch fixed in 626954c.
    - ff_k 6141 -> 6535, ff_offset 2000 -> 853, physics_ff_c_fan 0.003 ->
    0.001634, FF flow LPF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
2026-10-01 Post-hand-over speed ramp: fix DP_FAULT on therapy start at 20 cmH2O
    Starts at 20 cmH2O failed intermittently with DP_FAULT (STSPIN830
    EN/FAULT) 0.28-0.44 s after the rev-up -> sensorless hand-over, at
    20-28 krpm. With pressure still ~0 the loop commands the ceiling; CM4
    applies that buffered target at the hand-over and the drive accelerates at
    ~35 krpm/s with iq_ref pinned at IQMAX (sampled iq 1.3-1.7 A). With the
    motor's ~50-70 uH in-situ inductance the 20 kHz ripple rides on top, and
    the peaks reach the driver's internal over-current threshold (3 A min,
    3.5 A typ). Changing speed_ki / rpm_max made no difference (0/8 vs 0/8).
    blower_ctrl.c: while CM4 is not in RUN the speed ceiling is hel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
2026-10-01 Speed-dependent current boost and stiffer CM4 speed loop
    Current limit (CM4 speed-PI output), runtime-settable:
    - foc set iq_max_ma / iq_boost_ma / iq_boost_lo_rpm / iq_boost_hi_rpm.
    In RUN the limit is 1650 mA from 20 krpm up to 35.5 krpm, tapering to
    IQMAX_A (1445 mA) by 37 krpm; 1445 everywhere else (below 18 krpm, so
    starts are unchanged). Applied every speed-loop tick from the
    medium-frequency hook. "iq_boost_ma 0" turns it off.
    - Breathing A/B 2026-10-01: 1650 flat halved the 16 cmH2O onset dip but
    tripped DP_FAULT once at 38.2 krpm at 20 cmH2O, where current control
    degrades above ~37 krpm; a 37000 speed ceiling instead was worse
    (20 cmH2O needs the speed). With the boos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
2026-10-01 Revert CM4 speed_kp default to 1637
    speed_kp 4000 (9e16849) tripped DP_FAULT six times in therapy at 16
    cmH2O and never at 1637 in interleaved blocks. CM7 posts a speed every
    5 ms tick with ramp 0, so the CM4 reference steps; at 4000 each step is
    a 2.4x larger iq_ref step and the phase-current peaks reach the
    STSPIN830 3 A trip. The bench replays that cleared 4000 sent 100 ms
    ramps and hid it.
    Reproduced on the bench afterwards with closed-loop therapy (vent only,
    no breathing): unfiltered 4000 tripped DP_FAULT, and even with the CM7
    P-error filter 4000 doubled the command jitter and quadrupled the
    current chatter against 1637. Do not raise kp without limiting how fast
    the reference / iq_re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
2026-10-01 CM7: bench playback, P-error filter, over-pressure gain 3
    Bench playback (new bench_playback.c/.h, both Keil targets):
    - "bench play clear/period/add/start/stop/status" loads a recorded
    speed command into RAM (3000 samples) and posts it to CM4 every 5 ms
    control tick with ramp 0 - the therapy cadence the PC cannot reproduce.
    - Manual blower mode only, therapy idle, controller off; stops on a CM4
    fault or leaving that mode; clamped to [15000, safety ceiling].
    - "# PLAY,start/end,<ms>,..." markers carry the device clock.
    - BENCH_PLAYBACK 0 compiles it out. Telem_PushNote added for the markers;
    the T line's cmd shows the played speed while active.
    P-error low-pass (blower set p_err_lpf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
2026-10-01 FF steady-state refit and expiratory-tail fall fix
    FF offset refitted to the current air path by the integrator method
    (CPAP on the bench, vent only, no breathing; k and c_fan unchanged):
    ff_offset 853 -> 1541, ff_offset_slope 0 -> 94.3 rpm/cmH2O. The old
    values left the integrator settled at +1074..+2583 rpm over 4-20 cmH2O;
    fit residuals within +/-115 rpm. GUI ff_offset default 1541.
    Expiratory-tail hold could only slew the physics FF up. At rest
    |patient flow| < 3 L/min ~100 % of the time, so after a setpoint drop
    18 -> 6 cmH2O the FF froze ~7000 rpm above its own target for 100 s,
    the integrator hit -4000 and the mask sat +0.4 cmH2O high. New
    physics_ff_exp_tail_fall (default 2000 rpm/s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
2026-10-02 FF refit on the resealed air path: ff_k 6056, ff_offset 773
    The 2026-10-01 refit (ec35004: offset 1541 + 94.3*sp) was made while the
    blower -> flow-element joint leaked (from ~14:30 that day: pressure per
    rpm^2 -25 %, motor current per rpm^2 +27 % at the same measured flow).
    After resealing (health check: P/N^2 0.0240, iq/N^2 0.587 at 22-38
    L/min) the integrator method with the 2026-09-24 values (K 6535, offset
    853) settled at -1091..-2327 rpm over 4-20 cmH2O: a near-constant 7.6-8.0 %
    gain error, not an offset.
    Refit K and offset together, slope 0: ff_k 6535 -> 6056, ff_offset 773,
    ff_offset_slope 0; residuals +/-16 rpm. Checked live at 18 -> 6 -> 12 -> 4
    cmH2O (two drops): integrator sett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
2026-10-02 Flow guard fix and breathing-tuned CM7 set
    Flow sensor glitch guard (flow_sensor.c, declaration and init):
    dp_max_slew 50 -> 300 mbar/s, q_max_step 6 -> 15 slm per sample. At
    breathing flows (2-5 mbar across the flow element at 50-90 L/min) the
    turbulence noise alone exceeded 0.5 mbar per 10 ms sample: during human
    breathing at 20 cmH2O the guard rejected 23.6 samples/s, the flow was
    stale 18 % of the time and the device flow lagged the mask flow by
    ~0.20 s, so the physics FF steered on stale flow. After: 0 rejects, lag
    0.02 s, no glitches through (flow outliers vs a 7-point median p99
    6.5 / max 10.2 L/min vs 6.9 / 12.2 before).
    Breathing-tuned CM7 set (blower_ctrl.c, GUI defaults to match)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
2026-10-02 CM4 current boost default 1650 -> 1800 mA
    IQ_BOOST_DEFAULT_MA 1800 (the runtime ceiling), GUI default to match.
    On the sealed air path with the breathing-tuned CM7 set, a digital twin
    on identical recorded 20 cmH2O breaths gives inspiratory dip median
    -0.14..-0.27 cmH2O, p90 ~-0.35, p-p ~-0.3, end-inspiration spike +0.03.
    No DP_FAULT in: CM7 playback of a recorded 20 cmH2O breathing command
    on the leak rig (~80 L/min, limit reached 1800 mA, |Id| <= 0.24 A),
    closed-loop CPAP 20 <-> 18 cmH2O (vent only), and ~55 s of human
    breathing at 20 cmH2O (limit in force 1800 mA).
    Margin to the STSPIN830 3.0 A trip is estimated (phase peaks ~2.5-2.8 A
    with PWM ripple), not measured - scope the phase cu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
2026-10-02 CM7: fan-map flow estimate above the flow sensor range (off by default)
    The AMS5935 flow sensor clips at ~89 L/min, so for most of a deep
    inspiration at 16-20 cmH2O the controller saw a flat 89. While the sensor
    flags saturation, invert the fan map fitted on 2026-10-02 breathing data
    (P_dev = a N^2 + b N Q + c Q|Q| + d Q) from rotor speed and device
    pressure, and use the larger of that and the clipped reading.
    The estimate reaches the blower controller only (new Flow_GetSlmCtrl /
    Flow_GetSlmRawCtrl: physics FF flow and the controller's tube
    compensation). Flow_GetSlm - leak estimator, patient flow, mask-off
    detection, display - stays the sensor reading: feeding the estimate to the
    leak esti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
2026-10-02 CM7: correct the fan-estimate routing rationale in flow_sensor.c
    df95478 said the estimate was kept out of the leak estimator because the
    8.7*sqrt(P) vent model reads ~6 L/min high at 20 cmH2O. That model is the
    SIMPLE leak algorithm, which is not running: the active Vivo algorithm uses
    the bench vent table (leak_norm_table.h, BTPS-corrected) with a learned
    ratio. A vent-only bench calibration (2026-10-02, leak closed, 4-20 cmH2O)
    measured the circuit at 6.02 * P^0.537 L/min (30.1 at 20 cmH2O), within
    ~1-3 % of the Vivo vent reference, learned ratio 0.99-1.01.
    The routing itself is unchanged: the estimate still reaches only the
    blower controller, so leak learning and mask-off detection keep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
2026-10-02 CM7: refit fan-map flow estimate coefficients with the bench vent cal
    The fan map behind the saturated-flow estimate was fitted with true flow =
    mask flow + vent, using the 1 Oct rig vent curve 6.55 * P^0.537. The
    2026-10-02 vent-only bench calibration measured this circuit at
    6.02 * P^0.537 (30.1 L/min at 20 cmH2O), so the old map read ~1.4 L/min
    high against the corrected true flow (+1.4 +/- 1.6 L/min while saturated).
    Refit on the same breathing runs (rms 0.38 cmH2O):
    a 0.025645 -> 0.025508, b 0.0000581 -> -0.000290,
    c -0.00085374 -> -0.0008294, d -0.025769 -> -0.01916
    About 2.5 L/min lower at 33-37 krpm / 20 cmH2O. Estimate still off by
    default (flow set fan_est 1).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
2026-10-02 CM7: over_p_gain default 6 -> 4
    The x6 over-pressure gain jump was chosen this morning with a digital twin
    that had no loop delays. That twin also called speed_kp 2500/3000 and a CM4
    acceleration feed-forward stable; on the 20 cmH2O therapy bench all of them
    oscillated at 11-12 Hz into DP_FAULT. With 5 ms pressure-path + 5 ms
    command-path delay + 3 ms current lag (fitted to those bench results) and a
    breathing-only damping term, the twin reproduces all five bench outcomes and
    breathing to mean |err| 0.12 cmH2O. The x6 jump is what uses up the outer
    loop's stability margin.
    Twin, eight recorded 20 cmH2O breath sets, 4 vs 6: dip 1.70 -> 1.59,
    p90 2.63 -> 2.58, spike 1.99 -> 1.87, width 0.51 -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
2026-10-05 CM7: ~150 slm flow element support, made the default with a tuned set
    New element (same AMS5935): full scale ~160 slm vs ~93 for Round Hole_2,
    ~4 cmH2O less drop at ~115 slm. Its LUT (kFlowCalHi) comes from open-loop
    bench runs on a sealed circuit against external sensor + vent flow, scaled
    into the Round Hole_2 table's units (that reference reproduces the existing
    table to 0.993 +/- 0.020) and divided by the altitude factor so the reported
    flow matches; 20-111 slm measured, outside that extrapolated (below 20 slm
    not verified against a reference meter). Runtime switch: flow set element
    0|1; default now 1.
    Defaults retuned for it (bench + twin):
    flow_ff_deadband 3 -> 8 slm: its ~2x low-fl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
2026-10-05 CM7: mask-off fast path accepts sustained high flow as open-circuit evidence
    At the speed ceiling or on a saturated flow sample the fast path only
    fires if both pressures are at open-circuit level (mask < 4, device sensor
    < 6.5 cmH2O). With Round Hole_2 an open circuit read 3.5-5 at the device
    sensor because the element's large drop is upstream of it. The ~150 slm
    element drops far less: at 20 cmH2O with the mask pulled the device read
    14-16 and the mask estimate 11-13 at 129-155 slm, the gate never held, and
    only the 2.5 s rpm-ratio backstop parked the blower (at the 38.5 k ceiling
    into an open circuit, ~1.7 A, for 2.5 s).
    New g_therapy_mask_off_open_flow_slm (110, 0 = off; runtime
    "therap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
2026-10-05 CM7: recalibrate the ~150 slm element LUT - low-flow trim and own reverse branch
    Bench, open loop, sealed circuit, external sensor + vent as reference, now
    with the vent evaluated at device pressure minus hose drop (as the vent
    curve was measured; the external sensor's +0.45 offset was wrong near 0
    cmH2O) and with the measured LUT -> reported factor 0.933.
    Forward: new capped low-speed points (start at 14 krpm, step down to 2-3
    krpm, 2-14 slm) showed the first table reading 5-25 % high below 14 slm;
    it also read ~2 % low above 50 slm. Rebuilt in segments (low-speed fit,
    20-35 slm fit, open-outlet points as measured, scaled tail). Verified with
    the new build against the reference at 25 point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
2026-10-05 GUI: RPM max default 43000 -> 38500
    Therapy start sets the controller ceiling to the 38500 safety limit
    (g_safety_safe_rpm_max), but "Apply" sends the GUI's RPM max, so an Apply
    during therapy used to lift the ceiling back to the 43000 drive limit -
    above anything validated (current control degrades above ~37 krpm, the
    boost tapers out there). All other GUI tuning defaults were checked against
    the firmware defaults (74 blower, 10 FOC, flow units, 7 leak) and match.
2026-10-05 CM7: sustained-flow mask-off path (no pressure condition)
    Every other mask-off enter path needs the pressure to collapse below the
    setpoint. With the ~150 slm flow element the blower can hold a moderate
    setpoint with the mask off: at 12 cmH2O, mask removed, it held the mask
    estimate at 12.5 cmH2O with 157 slm flowing at 36.9 krpm and nothing fired
    (the blower kept running near the ceiling).
    New path 5: 3 s boxcar mean of total flow (50 ms bins) >= vent reference
    + g_therapy_mask_off_sustained_margin_slm (50) held for
    g_therapy_mask_off_sustained_ms (500). Not evaluated during the start-up /
    reconnect grace; window reset at therapy start and on park / un-park.
    Counts as arming for the safety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
2026-10-06 CM7: exp_flow_ff off by default, add expiratory-recovery lead
    BreathSimulator, 2 L lung, same breaths, external sensor at the lung,
    ~150 slm element.
    exp_flow_ff (2026-09-08 fit) predates the physics FF and counted the
    expiratory speed reduction twice: it sat at its -800 rpm cap through
    expiration and released late. Off, the end-of-expiration trough goes
    -0.77 -> -0.44 at 20 cmH2O and -0.41 -> -0.28 at 8; at 8 it was also
    dragging the expiratory plateau 0.2 below rest. Default 0 in firmware
    and GUI; runtime switch kept.
    New physicsFfExpLeadRpm: onset-lead counterpart while expiratory flow
    returns toward zero, k*(dQpat/dt - thresh), riding on top of the slew.
    Default on, k 5 / thresh 20 slm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
2026-10-06 CM7: hose inertance term in the controller's mask estimate (off)
    TubeComp_ApplyWithInertance subtracts L*dQ/dt from the static hose model;
    only the pressure controller uses it, the leak estimator keeps the static
    estimate. dQ/dt is total flow through a first-order filter with a soft
    deadband (the ~150 slm element's flow noise otherwise differentiates
    straight into the PID feedback).
    L = 0.0016 cmH2O per slm/s, fitted on the BreathSimulator from 21 capture
    windows at 8 and 20 cmH2O (external sensor at the patient end of the
    hose), robust to +-60 ms of pressure lag and consistent with rho*l/A for
    the hose. Twin: no instability, only noise (jitter 224 -> 260 rpm sd at
    50 ms / 80 slm/s).
    Bench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
2026-10-06 CM7: expiratory-tail hold band 3 -> 6 slm (rest ripple)
    With the ~150 slm element, patient flow at rest wanders ~0.5 slm sd and
    kept crossing the 3 slm band, so the physics FF switched between the
    tail hold and flow-following and pushed pressure along with the flow.
    BreathSimulator, 2 L lung, same breaths, external sensor at the lung at
    its full 100 Hz, rest ripple sd (cmH2O), two repeats:
    20 cmH2O 3: 0.076 / 0.077 6: 0.071 / 0.066 corr(P,Q) +0.5 -> +0.3
    8 cmH2O 3: 0.036 / 0.021 6: 0.028 / 0.020
    Inspiratory dip, spike, expiratory plateau and end-expiration trough
    unchanged at both setpoints. GUI default follows.
2026-10-07 CM7: recalibrate element LUT and FF for the new air path
    Air path changed 2026-10-06/07: element tap junctions glued (a tap leak
    read up to -5.6 slm at zero flow under pressure), mesh straightener
    between blower and element, blower moved into a new box (blower-outlet
    tube junction sealed).
    flow_sensor.c: forward kFlowCalHi rescaled by true/reported. References:
    4-43 slm with the vent taped and the patient end open (external sensor
    sees all the flow), 46-100 slm open-outlet points with 0.95 x vent law
    (the present vent passes ~5 % less than 6.02*P^0.537). The old forward
    table read +4..+10 % high at 12-44 slm; verified after flashing -0.6..
    -2.8 % at 12-43 slm. Reverse branch unchanged (not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
2026-10-12 CM7: APAP fixes from the BreathSimulator AutoSet trials
    From docs/APAP_FINDINGS_2026-10-12_breathsim.md (added here):
    1. Apnea timing: the episode clock now starts at the breath window (time
    since the last qualified breath), not at NO_BREATH entry, and the
    defaults are breath_window 12 -> 8 s, no_breath_timeout 4 -> 2 s, so
    FOT starts ~10 s after the last breath and ~10 s apneas can be scored
    (before: ~22 s needed, 10-20 s apneas never probed).
    2. Hypopnea duration accumulates the breath period instead of the
    inspiratory time (10 s of Ti needed >= ~20 s of hypopnea at I:E 1:1).
    3. Recovery breath (exit from NO_BREATH/FOT) is 0.30 x the peak baseline
    held when the episode b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
2026-10-20 docs: APAP findings - hypopnea threshold test (45 % / 55 %)
    Bench run on 9b67c19 with the BreathSimulator: 3 x 45 % and 3 x 55 %
    hypopneas, therapy started on a breathing patient.
    - 45 %: the CPAP sees 57-58 % of baseline peak -> FL only, 3 of 3.
    - 55 %: 47 / 47 / 50 % -> Hyp, Hyp, FL only.
    - The peak < 0.50 Hyp rule works as written; the boundary is sharp
    (<= ~49 % always Hyp, >= ~54 % never, ~50 % a coin flip).
    - By AASM's >= 30 % all six are hypopneas: the definition is a team call.
    - No CA, no FOT, OSA-likely 0, clean start.
    Also marks the CPAP working-tree commit (9b67c19) as done.
2026-10-20 docs: APAP findings - AirSense 11 reference runs and R13
    Same rig, same simulator scripts, ResMed AirSense 11 (AutoSet 8-12) in
    place of our CPAP, compared from its SD-card EDF files:
    - 8c script: central apneas identical (7 CA, 5 s not scored). AirSense
    scored no hypopneas (its ventilation estimate fell only 33-41 %) and
    never raised pressure (FlowLim 0) - ours scores Hyp at 55/60 % and
    titrates to ~10 cmH2O on its amplitude-only FL arm.
    - Flattened breaths at full volume: AirSense FL index plateau 90 % 0.42,
    M 90 % 0.60 (strongest), plateau 60 % <= 0.09; pressure 8 -> 12 in ~75 s
    (~3 cmH2O/min), down ~0.3 cmH2O/min. It titrates on shape, not amplitude.
    - Our CPAP on the same scr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
2026-10-20 docs: APAP findings - pressure lowering on our CPAP
    Plateau 90 % for 3 min, then 12 min of normal breathing:
    - rise 8.0 -> 9.2 cmH2O (0.4-0.6 cmH2O/min) vs the AirSense 8 -> 12 in
    ~75 s (~3 cmH2O/min): our raise is ~5-7x slower;
    - lowering starts 136 s after the block (FL flag off + the 120 s
    stable wait), then 0.48 cmH2O/min, back at 8 ~4.7 min after;
    - explains why 8c and the flattened-breath run never lowered (gaps
    <= 120 s).
2026-10-23 CM7: R13 - judge flow limitation on the whole inspiration
    The FL flatness was accumulated only in the EPR inspiration phase, which
    ends at the 1.2 s max-hold, so long inspirations were judged on their
    rising half: normal breaths sat on the 0.78 line and M-shaped limitation
    was caught only by accident.
    - One segment per inspiration: patient flow above fl_seg_floor (0 slm)
    containing an EPR onset, judged when the flow returns to the floor.
    A breath under way at a detector reset is skipped; an inspiration that
    never returns (flow offset) is closed at the next onset on its peak only.
    - fl_flat_ratio 0.78 -> 0.72 (For Her 0.74 -> 0.70).
    - New dip arm for M-type limitation (40 ms bins, lowe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
2026-10-23 CM7: APAP raise rate and lowering wait to AirSense-like titration
    On clear flow limitation the target rose ~0.5 cmH2O/min against the
    AirSense 11's ~3: fl_raise_scale 0.50 halved the 3/min standard rate, and
    the shape severity was measured over the span from the threshold to 1.0,
    so typical FL breaths sat on its 0.25 floor. Lowering waited 120 s with no
    FL / Hyp / snore, so in an eventful night the target only ratcheted up.
    - fl_raise_scale 0.50 -> 1.00 (For Her 0.55 -> 1.00; still gentler via
    response_soft and the her scale).
    - Shape severity reaches 1 at FL_SEV_SPAN (0.10) past the flatness / dip
    threshold.
    - stable_before_lower_s 120 -> 20 s (clamp 30..600 -> 5..600),
    lower_rate 0.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
2026-10-23 CM7: APAP - no pressure raise on central (round) hypopneas
    On round, low-effort hypopneas the AirSense 11 held 8.0 cmH2O and scored no
    flow limitation; ours raised to ~10 through two paths: the FL amplitude arm
    (peak < fl_ratio x baseline) called any reduced breath flow-limited, and
    every scored hypopnea raised pressure.
    - FL on breath shape only (flatness / dip); the amplitude arm is behind
    fl_amp_arm (default 0). A reduced breath still stays out of the FL/Hyp
    baseline, so hypopnea detection is unchanged.
    - Hypopneas classed by shape: obstructive when more than
    hyp_raise_shape_frac (0.5) of the event's limited breaths are
    shape-limited - raises as before; central otherwise - scored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
2026-10-23 CM7: RTC calendar for session timestamps (checklist #66)
    There was no RTC: every EDF session went into DATALOG/20260101 unless the
    date was sent over USB, and the date never advanced between sessions.
    - rtc_clock.c/.h: H7 RTC calendar by direct register access (hal_conf.h
    and the HAL RTC driver untouched). RtcClock_Init() starts the LSE at
    boot; RtcClock_Service() (SelfTestTask) waits up to 4 s for it, falls
    back to the LSI, and starts the calendar without blocking boot. Keeps
    counting across resets; "valid" (BKP0R magic) once the time has been
    set since the backup domain was last lost, else counts from
    2026-01-01. Boot trace keeps BKP18R/BKP19R.
    - EDF sessions take their folder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
2026-10-26 CM7: EVE.edf event annotations for OSCAR (checklist #59)
    Scored respiratory events now go to a per-session
    DATALOG/YYYYMMDD/YYYYMMDD_HHMMSS_EVE.edf next to BRP/PLD, in the AirSense
    11's own EVE format (verified byte for byte, CRC included, against the
    20 Oct reference card): EDF+D, "EDF Annotations" (31) + "Crc16" (1),
    64-byte records of "+0" time-keeping + one event TAL, CRC-16/CCITT-FALSE
    little-endian, "Recording starts" first.
    - Texts OSCAR's ResMed loader maps: Obstructive Apnea, Central Apnea,
    Hypopnea. Like ResMed, stamped at the event END with its duration, on
    the BRP sample clock so flags line up with the waveform.
    - apap_ctrl.c: an apnea is written when its episode ends (R8b d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
2026-10-26 CM7: per-session summary record in SUMMARY.CSV (checklist #57)
    One line per therapy session, appended to 0:/SUMMARY.CSV when therapy
    stops (schema version in column 1; columns only added at the end):
    start/end (RTC) and rtc_valid, run / mask-on / mask-off time and mask-off
    count, mode and settings, mask pressure avg/min/max/P50/P90/P95, leak
    avg/P50/P95/max and time above/below threshold, scored OA/CA/Hyp/FL/snore
    with AHI/RDI/SI per hour of mask-on time, and the session's DATALOG name.
    - session_summary.c/.h: RAM snapshot at Therapy_Stop, SD append from
    SelfTestTask while the card is mounted (EDF logging on). Mode and
    settings latched at therapy start (the bench shutdown switches to CP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
2026-10-26 CM7: adherence metrics from SUMMARY.CSV (checklist #65)
    adherence.c/.h: built from the session records on the card - read once
    per card mount (columns by header name, f_read line assembly since FatFs
    string functions are off), each new record added as it is written.
    - Night = the night a session started in, split at noon like ResMed;
    usage = mask_on_s; rtc_valid 0 records counted as undated, left out.
    - Last 30 nights ending tonight (never before first use): nights used,
    >= 4 h, share, average usage over all / used nights; since first use;
    reimbursement test = best 30-night window in the first 90, met at
    >= 21 nights >= 4 h. Without a valid clock, tonight = last night with a
    sessi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
2026-10-26 CM7: mount the SD card whenever one is in, not only with EDF logging
    SUMMARY.CSV (#57) and adherence (#65) need the card for every session,
    but it was mounted only by "therapy edf enable 1", and nothing unmounted
    it when the card was pulled.
    - session_edf_log.c: mount once a card is present, self-tested and
    settled, independent of the EDF enable, which now only switches the
    BRP/PLD/EVE waveform files. Pulling the card detaches the volume and
    drops open files without I/O to the missing card (error 0x1000 if a
    session was logging). A failed mount is not retried until the card is
    reinserted or "therapy edf enable 1" is sent.
    - adherence.c: clear the counts when the card goes, so "bui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
2026-10-26 CM7: score respiratory events in CPAP mode too (checklist #33)
    The APAP detectors only ran in AutoSet, so a fixed-pressure night logged
    no events: no EVE flags, events_scored=0 in SUMMARY.CSV, no AHI.
    - apap_ctrl.c: in CPAP mode the detectors start score-only (setting
    cpap_scoring, default 1): OA / CA / Hyp / FL / snore are scored exactly
    as in AutoSet, including the FOT patency probe during apneas (as ResMed
    does in CPAP mode), while every pressure change is blocked - gradual
    raise, step raise and lowering - and the range is pinned to the set
    pressure. Apap_IsScoreOnly(), Apap_WasSessionScored().
    - therapy.c: Apap_OnTherapyStart(P, P, mode) in CPAP mode and Apap_Update
    each tic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
2026-10-26 CM7: durable fault log in FAULTS.CSV (checklist #86)
    Faults were only a RAM latch plus a debug-log line; nothing survived a
    reset or could be read back in the field.
    - fault_log.c/.h: one record per fault with the state around it - RTC
    time + uptime, source, code, name, detail, therapy state / mode / run
    time, target / setpoint / measured pressure, flow, leak, commanded and
    measured rpm, Iq / Id, bus voltage, CM4 state and fault bits. RAM ring
    of the last 16; appended to 0:/FAULTS.CSV (schema comment + header)
    whenever the card is mounted, pending ones at the next mount.
    - Sources: every Therapy_LatchFault() (captured before the blower is
    stopped), and new bits in the CM4 occurr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
2026-10-26 CM7: IWDG1 watchdog with per-task check-in (checklist #80)
    IWDG1 (~1 s) is refreshed only from SafetyTask, and only while every
    monitored task (sensors, system, gui, climate, nfc, selftest) has checked
    in within its own deadline, so a stuck task is not masked. A missed
    deadline latches and the system resets.
    The reason (stalled task, or fault handler + PC, or Error_Handler caller)
    is left in RTC BKP15R..17R; at boot it is read with RCC_C1_RSR and an
    abnormal reset is written to FAULTS.CSV as a "system" record once the RTC
    is running. Fault handlers now read the stacked PC from task stacks in
    AXI SRAM too.
    USB: wdg, wdg clear, wdg test stall|hang|fault (blower stopped only).
    Bench-verified: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
2026-10-27 CM7: snore and flow-limitation indices in PLD and SUMMARY (checklist #60, #61)
    - PLD gains Snore.2s (0..5, RMS / threshold while snore is on) and
    FlowLim.2s (0..1, per-breath flatness / mid-dip score), AirSense scaling.
    - SUMMARY.CSV schema 2: fl_idx_avg, fl_idx_p95, fl_s, snore_s; a new
    header line is appended when the file's last header differs.
    - Snore detector fixes: count over the whole inspiration (R13 segment)
    instead of the ~1.2 s EPR phase, which was shorter than snore_on_s so
    snore could never turn on; replace the 1st-order HP (wrong coefficient)
    plus breath-LPF residual, which passed ~10 % of the breath, with a
    2nd-order Butterworth HP. Clean breathing now reads ~0.2 s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
2026-10-27 CM7: AutoRamp and periodic breathing / CSR (checklist #38, #32)
    AutoRamp (#38): `therapy set ramp auto` / GUI ramp "Auto" holds 4 cmH2O
    until sleep onset - 30 stable breaths, 3 obstructive apneas or any
    hypopneas within 2 min, or 5 snore breaths in a row - then rises at
    1 cmH2O/min, reaching the target 30 min after start at the latest.
    The APAP detectors now score through any ramp with titration frozen
    (target restored every tick). `therapy ramp status` reports it.
    Periodic breathing (#32): new periodic_breath.c - ventilation envelope
    at 1 Hz over 240 s, periodic when std/mean >= 0.30 and the
    autocorrelation peaks >= 0.40 at 30-100 s with anti-correlation at half
    the lag. Spans go to a new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
2026-10-27 CM7: leak-invalidated scoring, ramp start pressure, EDF on by default (checklist #19, #5)
    #19: unintentional leak HIGH for 3 s excludes scoring until 10 s after
    it drops - no apnea / hypopnea / FL / snore is counted or annotated, FL
    and snore time and the PLD indices stop, the CSR detector closes its
    span, and the time leaves the AHI / RDI / SI denominator. SUMMARY.CSV
    schema 4: leak_excl_s, leak_excl_n; `therapy apap events` lx / lx_s /
    lx_n / lx_drop; `apap set leak_excl 0|1`, leak_excl_enter_s / _exit_s.
    #5: ramp start pressure (AirSense "Start Pressure"): `therapy set
    ramp_start`, GUI My Options "Ramp Start", 4.0 up to the CPAP pressure
    or AutoSet minimum. Used by the fixed ramp and Aut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
2026-10-27 CM7: pre-therapy self-test (checklist #83)
    New precheck.c, run by Therapy_Start before anything is armed, from
    values the sensor loop already keeps (never blocks). A hard failure
    refuses the start with THERAPY_FAULT_PRECHECK (6): screen "Self-test:
    <what>", FAULTS.CSV entry with the check and frozen times.
    Hard: mask pressure / flow / ambient sensor frozen (raw word unchanged
    500 ms / 500 ms / 3 s), mask pressure outside -10..+50 cmH2O or > 3 off
    zero at rest, NaN or saturated flow, ambient outside 500..1150 mbar,
    CM4 status not advancing for 500 ms, drive fault active, motor supply
    outside 20..28 V. Warn: analog pressure sensor > 2 cmH2O from mask
    sensor, no SD card, clock not set, humidit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
2026-10-27 CM7: blower spin check in the pre-therapy self-test (checklist #83)
    After the static checks pass, therapy enters THERAPY_STATE_PRECHECK (5,
    appended) and runs the blower open-loop at 12000 rpm (~3 cmH2O). Once
    the rotor has held that speed for 0.5 s, device pressure, flow and
    speed are sampled for 1 s. Refused (THERAPY_FAULT_PRECHECK) when the
    speed is off by > 1500 rpm (or not reached in 6 s), the pressure is off
    the fan map for that speed and flow by > 0.8 cmH2O + 15 % - pressure,
    flow and speed must agree whatever the load - or either sensor is flat
    or grossly noisy while the blower runs. A pass hands the spinning motor
    to the pressure loop without a stop. `therapy precheck spin|map 0|1`;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
2026-10-27 CM7: learn circuit - measure the attached tube (checklist #85)
    With the mask off the tube (end open to the room) the device sensor reads
    the tube's pressure drop directly. circuit_learn.c zeroes the sensors,
    steps the blower open-loop 12000..26000 rpm (5 steps, 1 s averages),
    ramps down under control and fits drop = R_lam*Q + R_turb*Q^2. A good
    result replaces the tube_comp coefficients.
    - Open-end check at the first step: P < 60 % of the fan shut-off, P <
    0.0015*Q^2 (map-free) and Q >= 20 L/min, else not_open at ~3 cmH2O.
    - Verdicts: speed, drive, few_points, low_flow, fit (rms), high (> 3
    cmH2O at 60 L/min); climb stops at 10 cmH2O / 140 L/min / saturation /
    0.8 A. Warnings: differs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
2026-10-27 CM7: sensor calibration - in-service zero, field span, CAL.CSV (checklist #84)
    sensor_cal.c keeps what drifts in service on top of the factory
    calibration, and records every change.
    - Device pressure: corrected = (raw - offset) * gain, applied where PS is
    read so every consumer sees the same value. The offset is learned while
    therapy is idle and the blower has been stopped 3 s with no flow (three
    quiet 1 s windows, pp <= 0.2 cmH2O), on every stop and every 10 min of
    idle. More than 1.5 cmH2O off the factory zero it is refused and the
    self-test refuses to start (ps_offset).
    - Flow: the idle auto-zero refuses a zero more than 0.05 mbar (~5 L/min)
    off the factory zero; the self-tes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
2026-10-28 docs: #25 findings - the error is in the subtracted vent / leak model
    Adds to the #25 section of APAP_FINDINGS: patient flow is a small
    difference of large numbers (total 12-40 L/min minus vent and leak), so
    the issue is the accuracy of the subtraction, not flow-sensor resolution.
    R10's capture already shows total flow is right and the model
    over-subtracts 0.7 L/min in normal breathing and 2.5 L/min in a 60 %
    hypopnea - the source of both the -3 L/min pause offset and the
    small-breath size dependence. Recommended option is now to measure and
    fix the vent / leak model at its source; the earlier "check flow-element
    linearity first" suggestion is withdrawn.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
2026-10-28 docs: #25 findings corrected - cause is total flow at low / reverse flow
    Replaces the previous commit's conclusion. The R10 three-sensor capture,
    repeated on the current build at 4 and 8 cmH2O, shows the subtracted vent
    / leak model is close to right on average (+0.6..1.0 L/min, patient-flow
    breath mean ~0; the -2.1 L/min hypopnea offset was pre-R10). The error is
    inside the breath: the flow element under-reads expiration where total
    flow is low or reversed (total - external 3-5 L/min high there; 12 % of
    breathing reverse at 4 cmH2O, 7 % at 8), VIVO's volume balance shifts the
    trace down, and the pause sits at -2..-3 L/min. Recommended fix:
    recalibrate the element's reverse branch / low-flow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
2026-10-28 CM7: supplies replacement reminders (checklist #87)
    service_reminders.c: filter, mask cushion, mask, tube and water chamber,
    each due on usage hours or calendar days, whichever comes first.
    ResMed-style intervals (30 / 30 / 90 / 90 / 180 days; hours = the same
    period at 8 h a night); SOON at 90 %, DUE at 100 %.
    - Usage hours: blower run time of every session in SUMMARY.CSV (new
    Adherence_GetRunSeconds, dated or not) plus the running session, so
    they count without a valid clock. Days need the RTC.
    - Measured filter blockage: each therapy start logs the #83 spin check's
    device pressure minus the fan map at 12000 rpm (new spin verdict seq,
    one log per start). DUE when the median of the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
2026-10-29 CM7: smooth setting transitions during therapy (checklist #8)
    - therapy.c: the pressure the session is given (CPAP setting or AutoSet
    target) reaches the blower setpoint at <= 0.5 cmH2O/s, so a pressure
    change, CPAP <-> AutoSet or a new AutoSet range moves over seconds
    instead of a ~0.3 s step (the blower's own 18 cmH2O/s slew is sized for
    EPR). AutoSet's own changes, EPR and FOT are unaffected. Ramp hands its
    last setpoint over; a new session takes the target directly.
    - epr_ctrl.c: EPR switched on mid-session starts its relief at the first
    exhalation after the command (no snap, no breath-detector reset);
    switched off, the relief is removed at the next inspiration (or slewed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
2026-10-29 CM4/CM7: Micronel U65ML-024KEE-5 blower
    Repository copied from CPAP_InitialCode at 2c4c25f (WM6850 tuning) and
    retargeted at the Micronel U65 radial blower.
    CM4, from the Workbench profile Micronel_U65.json and its reference
    project D:\Code\CPAP_Micronel (same STSPIN830 current sensing: 0.165 ohm,
    x1.53):
    - RS 0.74, LS 0.11 mH, Ke 0.4, 1 pole pair, nominal / IQMAX 1.316 A
    - observer GAIN1 -10231 / GAIN2 9219 (F1 8192), PLL 1081 / 38
    - current PI 3412 / 2285 (= the WM6850's 2168 / 806 scaled by Ls, Rs)
    - MAX_APPLICATION_SPEED_RPM and BLOWER_IPC_MAX_SPEED_RPM 40626
    - start-up: align 1000 ms, rev-up to 16250 rpm, observer from 14625
    Kept: rev-up 4322 ms (Workbench's 32500 would pass CM7's 10 s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
2026-10-29 CM7: safety checks judge against the commanded pressure (#8 follow-up)
    With setting changes slewed at 0.5 cmH2O/s (#8), a large decrease keeps
    the measured pressure above the new target for many seconds. The safety
    supervisor compared it with the target alone, so coming down 18.5 -> 4
    cmH2O latched OVER_PRESSURE after 3 s (found on the Micronel bench,
    2026-10-29).
    - therapy.c: Therapy_GetCommandedPressureCmh2o() - the slewed base while
    a change is being slewed (RAMP / RUNNING), else the target.
    - safety_supervisor.c: over-pressure is judged against the higher of the
    target and the commanded pressure (a slow decrease is not a fault, an
    increase is still judged on the target); RPM-satur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
2026-10-29 CM7: feed-forward refit for the Micronel U65
    The WM6850 feed-forward (ff_k 6159, ff_offset 667) was ~7 % high on the
    U65: settled integrator -870 rpm at 4 cmH2O to -1950 at 20 cmH2O.
    ff_cal.py k+offset fit (circuit: hose + vent + external sensor + the
    BreathSimulator stopped, CPAP scoring off): ff_k 5753, ff_offset 618,
    slope 0, residuals within +/-10 rpm over 4-20 cmH2O. Flashed check: I
    -31 / +48 / +39 rpm at 20 / 6 / 12 cmH2O. Same values as the PC GUI
    defaults (pc_tools/cpap_telemetry_plot.py).
2026-10-29 CM7: split the fan-load term into inspiratory and expiratory coefficients
    Port of CPAP_TKFan f0f39f8. The physics feed-forward's fan-load term
    c_fan * Q^2 (Q = total device flow) now uses c_fan only at or above the
    resting flow (vent + leak, physicsFfVentFloorQSlm). Below it - expiration,
    when the patient supplies part of the vent flow - the drop from the resting
    value uses the new physics_ff_c_fan_exp:
    Q >= Qr: fan_load = c_fan * Q^2
    Q < Qr: fan_load = c_fan * Qr^2 - c_fan_exp * (Qr^2 - Q^2)
    The term is continuous at Qr; c_fan_exp == c_fan reproduces the old model.
    Micronel U65, BreathSimulator (10 bpm, 74 L/min peak, 20 cmH2O), runtime
    sweep on the same breaths, patient end: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
2026-10-29 CM7: over_p_gain 4 -> 2, under_p_gain 5 -> 2.5 for the Micronel U65
    The pressure loop rang at ~13 Hz through inspiration and the
    end-inspiration spike. Device telemetry: the rotor speed oscillation
    (8-18 Hz, 235 rpm rms vs 20 on TKFan) accounts for the pressure ripple,
    coherence 0.97, and the loop sat at ~180 deg phase / gain ~1 at 13.6 Hz.
    The U65 rotor follows a 13 Hz speed command ~2.7x more than the TKFan's on
    the same speed PI, so the WM6850-tuned x4 over-pressure / x5 under-pressure
    P-gain jumps left the outer loop no margin.
    BreathSimulator, 10 bpm, ~74 L/min peak, patient end, same-session A/B
    (rotor = 8-18 Hz rotor speed ripple; ring = 5-20 Hz pressure rms over
    inspiration + spike)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
2026-10-29 CM4/CM7: drive fault recorder (25.6 ms of FOC data before a DP_FAULT)
    DP_FAULT tripped the Micronel U65 at ~33 krpm on the open air path while
    the 25 Hz B-line telemetry showed nothing unusual before it, so the cause
    had to be found at FOC rate.
    - Common/Inc/fault_rec.h, Common/Src/blower_ipc.c: g_fault_rec in D3
    SRAM4 at 0x38000400 (new RW_FREC scatter region, 15 KB, both cores):
    a 512-sample ring (20 kHz -> 25.6 ms) of ia, ib, iq, id, vq, vd,
    electrical angle, TIM8 CCR1-3 and the SVPWM sector, plus a header with
    the trigger, speed, bus voltage and the unit conversions.
    - CM4: FaultRec_Record after the FOC high-frequency task (mc_tasks.c
    USER CODE), FaultRec_Freeze in the TIM8 br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
2026-10-29 CM4: boost taper 33-35k and high-speed derate 36.5-38k for the U65
    The 38.5-40k taper assumed the U65's lower Ke would push the
    high-modulation region past its cap. It does not: on the leak rig (leak
    port fully open) it runs 84 % of the linear limit at 34k, 90 % at 36k and
    96.5 % at 38k - the same speeds as the WM6850, whose boost stopped at
    35.5-37k. The boost now tapers 1800 -> 1316 mA over 33-35k and the
    high-speed derate takes the limit to 1100 mA over 36.5-38k (was 39k ->
    40.6k), so the speed PI cannot hold large currents at high speed.
    The comment records what the DP_FAULT trips turned out to be (fault
    recorder, previous commit): the STSPIN830's thermal shutdown under
    sustained curren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
2026-10-29 CM4: I2t thermal fold-back for the STSPIN830 (drive no longer trips under sustained load)
    The DP_FAULT trips at high load are the STSPIN830's thermal shutdown (fault
    recorder: control loop healthy to the last tick; chip hot to the touch).
    On this board it sustains far less than its 1.5 A rms rating, and time at
    current decides (U65, phase-current amplitude):
    1.21 A held 90 s from cold
    1.44 A tripped 4.6 s into a hold after a 6 s ramp from cold
    2.0 A breathing peaks of a fraction of a second never trip
    BlowerIpc_CM4_UpdateIqLimit now models it last, after boost and derate:
    theta = filtered (|Iqd| / 1.15 A)^2, heating 4 s, cooling 8 s
    (deliberately slower). From theta 0.85 the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
2026-10-29 CM7: "foc rec arm" / "foc rec freeze" - recorder snapshots without a fault
    The fault recorder only froze on a fault, and "foc rec dump" read the ring
    while it was still being written, so its samples were not contiguous - no
    good for a spectrum. "foc rec arm" restarts the ring from the CM7 (the CM4
    writer checks armed/frozen every tick, so the reset is safe); 25.6 ms later
    "foc rec freeze" stops it (src=3, FAULT_REC_SRC_MANUAL) and "foc rec" dumps
    a clean snapshot. The CM4 still re-arms on every start and freezes on any
    fault.
    First use, Micronel U65 at 28k and 30k (iq 0.95 / 1.08 A): the current
    ripple at 6 x fe (2.8 / 3.0 kHz) is ~0.1 A in iq and ~0.13 A in id, about
    10 % of iq, and does n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
2026-10-30 CM7: integrator warm-up settle band 0.15 -> 0.3 (therapy-start late-expiratory sag)
    Every therapy session on the Micronel U65 started with a late-expiratory
    sag of -0.5..-0.66 cmH2O at 20 cmH2O that ended abruptly ~98 s after
    therapy start. Not the leak estimator (settled within ~9 s, flat after) and
    not the feed-forward (unchanged either side): the integral term in late
    expiration sat at ~-1500 rpm during the sag and ~-500 after.
    Cause: the integrator's error LPF starts at tau 1 s and only ramps to 15 s
    while |filtered error| <= the settle band (0.15 cmH2O), the clock running
    backwards when out of band. 0.15 was set on the WM6850, whose ripple at
    tau 1 s was +/-0.097; the U65 breathes hard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
