vsimhas/CPAP_Micronel/(notices)

Notices in the files:
CM4/Core/Inc/main.h:
This software is licensed under terms that can be found in the LICENSE file
